MalauD/TIPE2022/Code/Notebooks/data/README.md

## Utilisation des donnés
### Formattage des noms de fichier
Exemple :
`002_chaussure_revetement.csv`

En premier on retrouve le numéro de session et ensuite c'est la chaussure et enfin le revetement
