MalauD/TIPE2022/Diapo/slides/00_titre_et_tdm.tex

\begin{frame}
    \titlepage
\end{frame}

\begin{frame}
    \frametitle{Problématique}
    Quelle est l'influence du type de revêtement de sol et du chaussage sur le corps humain lors de la course à pied ?
\end{frame}

\begin{frame}
    \frametitle{Plan de l'exposé}
    \tableofcontents
\end{frame}
