MalauD/TIPE2022/Diapo/slides/01_intro.tex

\section{Présentation du problème}
\begin{frame}
    \frametitle{Présentation du problème}
    Les sols dans nos villes sont souvent bétonnés et ne sembleraient donc pas optimaux pour les coureurs, est-ce vraiment le cas ? Quelle influence peut avoir le chaussage sur le confort du coureur ?
    \\
    \\
    Nous allons le vérifier à l'aide d'un dispositif expérimental.
\end{frame}
