MalauD/TIPE2022/Diapo/slides/04_conclusion.tex

\section{Conclusion}
\begin{frame}
    \frametitle{Conclusion}
    D'après les résulats expérimentaux et le modèle physique:
    \begin{itemize}
        \item Un chaussage adapté est primordial pour atténuer les chocs
        \item Le revêtement le moins traumatisant est le gazon
    \end{itemize}
    Dès lors, la bétonisation des sols est traumatisante pour les coureurs.
\end{frame}
