MalauD/TIPE2022/Diapo/slides/05_annexe.tex

\section{Annexes}
\subsection{Photos}
\begin{frame}
    \frametitle{Annexe 1}
    \begin{figure}
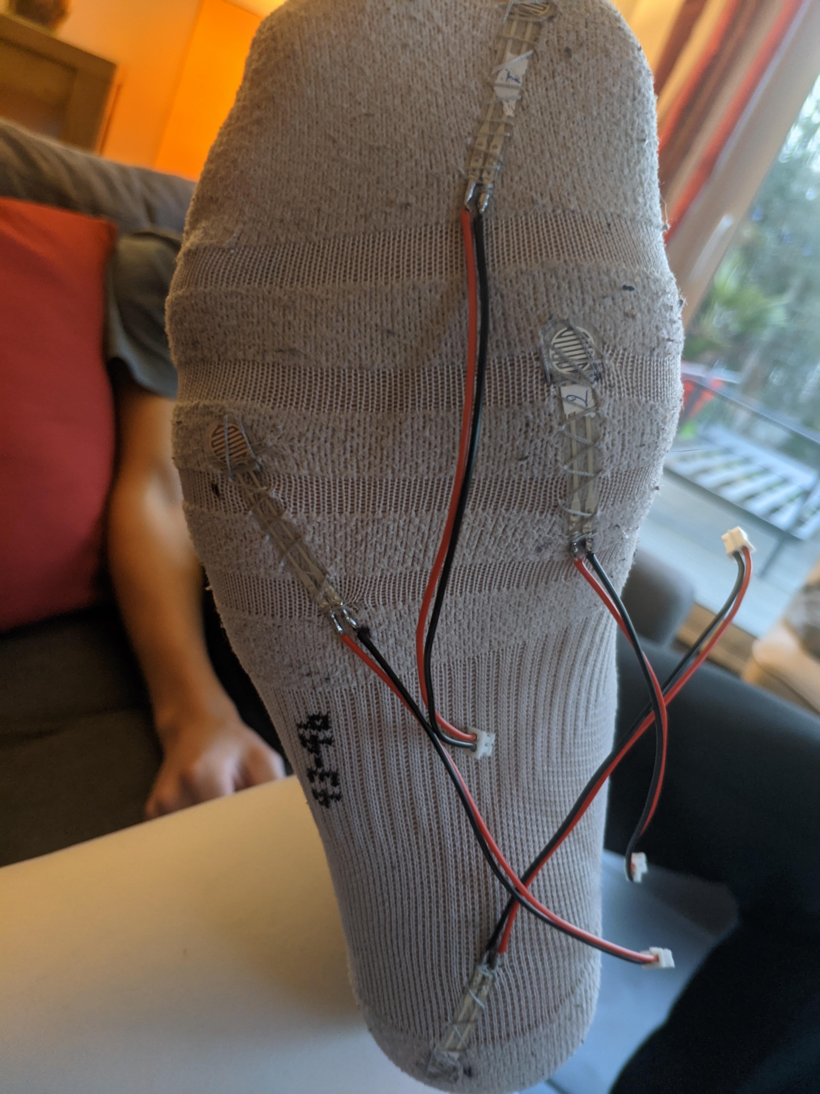
[picture p12: Diapo/figures/chau_02.jpg]
        
    \end{figure}
\end{frame}
\begin{frame}
    \frametitle{Annexe 2}
    \begin{figure}
        
    \end{figure}
\end{frame}
\begin{frame}
    \frametitle{Annexe 3}
    \begin{figure}
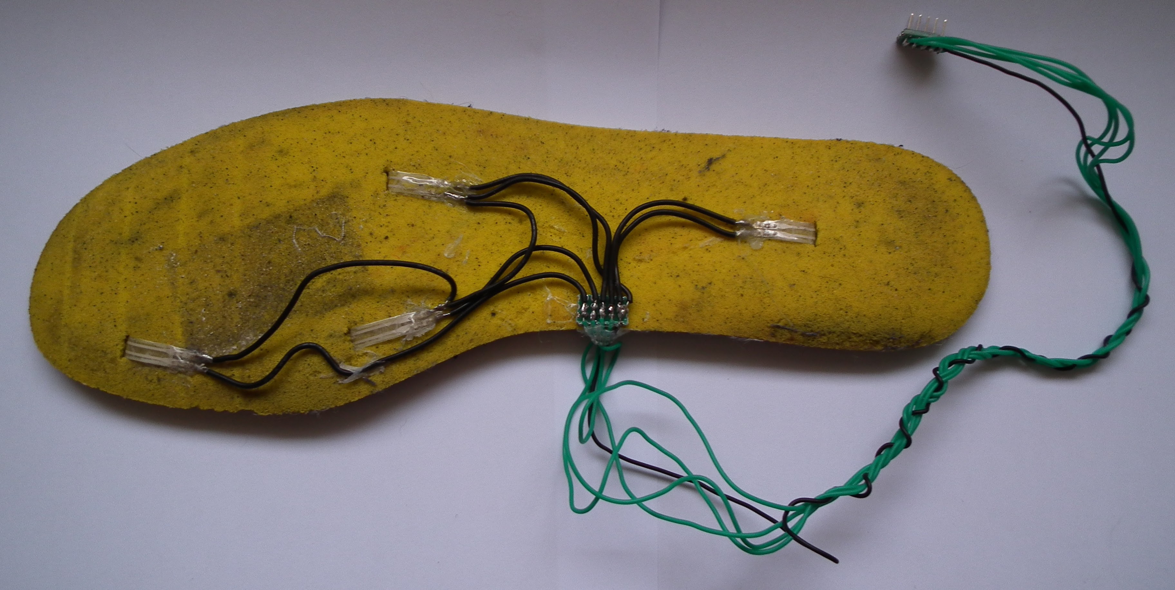
[picture p13: Diapo/figures/sem_03.JPG]
        
    \end{figure}
\end{frame}
\begin{frame}
    \frametitle{Annexe 4}
    \begin{figure}
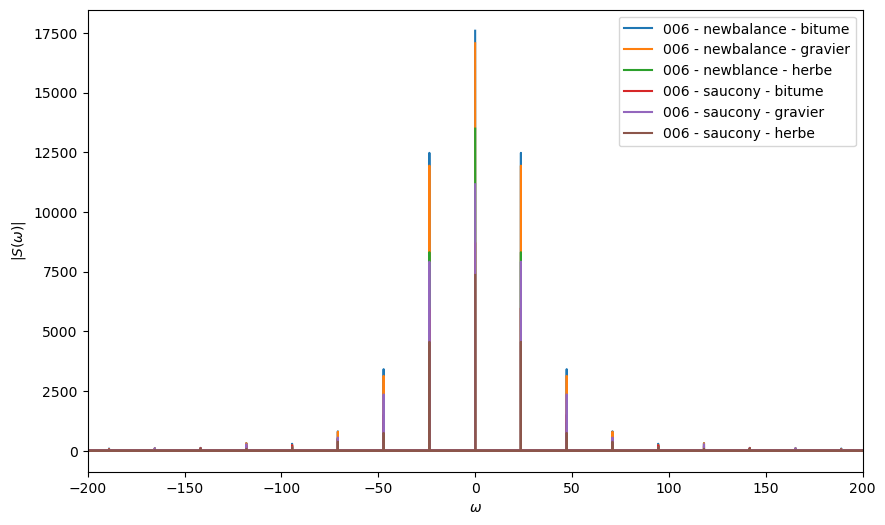
[picture p14: Diapo/figures/rheo_03.png]
        
    \end{figure}
\end{frame}
\begin{frame}
    \frametitle{Annexe 5}
    \begin{figure}
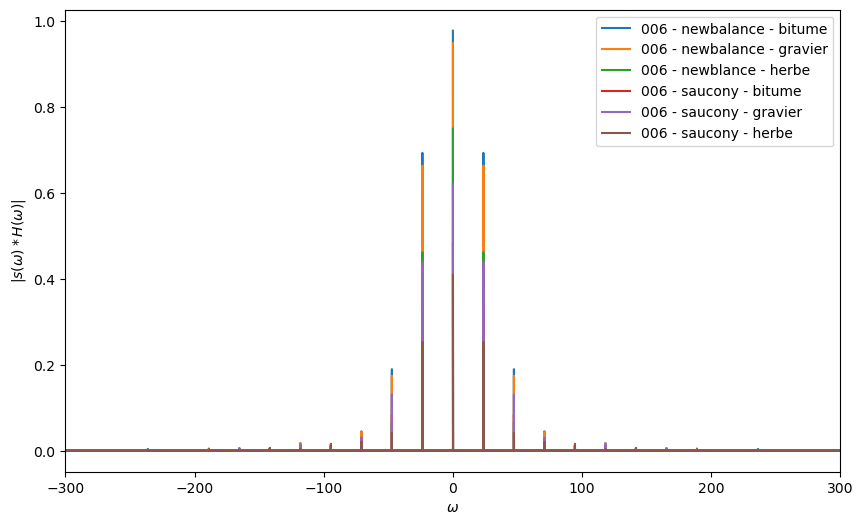
[picture p15: Diapo/figures/rheo_04.png]
        
    \end{figure}
\end{frame}
\subsection{Codes}
\begin{frame}
    \frametitle{Annexe 6}
    \lstinputlisting[language=C++, basicstyle=\tiny, linerange={140-147,160-177}]{../Code/Tipe/include/math/fitting/gradient_desc.hpp}
\end{frame}
\begin{frame}
    \frametitle{Annexe 7}
    \lstinputlisting[language=C++, basicstyle=\tiny, linerange={179-208}]{../Code/Tipe/include/math/fitting/gradient_desc.hpp}
\end{frame}
\begin{frame}
    \frametitle{Annexe 8}
    \lstinputlisting[language=C++, basicstyle=\tiny, linerange={209-226}]{../Code/Tipe/include/math/fitting/gradient_desc.hpp}
\end{frame}
