MalauD/TIPE2022/Diapo/preambule/special_beamer.tex

%%%%%%%%%%%%%%%%%%%%%%%%%%%%%%%%%%%%%%%%%
% Beamer Presentation
% LaTeX Template
% Version 1.0 (10/11/12)
%
% This template has been downloaded from:
% http://www.LaTeXTemplates.com
%
% License:
% CC BY-NC-SA 3.0 (http://creativecommons.org/licenses/by-nc-sa/3.0/)
%
%%%%%%%%%%%%%%%%%%%%%%%%%%%%%%%%%%%%%%%%%

%----------------------------------------------------------------------------------------
%	PACKAGES AND THEMES
%----------------------------------------------------------------------------------------

\mode<presentation> {

  % The Beamer class comes with a number of default slide themes
  % which change the colors and layouts of slides. Below this is a list
  % of all the themes, uncomment each in turn to see what they look like.

  %\usetheme{default}
  %\usetheme{AnnArbor}
  %\usetheme{Antibes}
  %\usetheme{Bergen}
  %\usetheme{Berkeley}
  %\usetheme{Berlin}
  %\usetheme{Boadilla}
  %\usetheme{CambridgeUS}
  %\usetheme{Copenhagen}
  %\usetheme{Darmstadt}
  %\usetheme{Dresden}
  %\usetheme{Frankfurt}
  %\usetheme{Goettingen}
  %\usetheme{Hannover}
  %\usetheme{Ilmenau}
  %\usetheme{JuanLesPins}
  %\usetheme{Luebeck}
  %\usetheme{Madrid}		
  %\usetheme{Malmoe}
  %\usetheme{Marburg}
  %\usetheme{Montpellier}
  %\usetheme{PaloAlto}
  %\usetheme{Pittsburgh}
  %\usetheme{Rochester}
  %\usetheme{Singapore}
  %\usetheme{Szeged}
  \usetheme{Warsaw}

  % As well as themes, the Beamer class has a number of color themes
  % for any slide theme. Uncomment each of these in turn to see how it
  % changes the colors of your current slide theme.

  %\usecolortheme{albatross}
  %\usecolortheme{beaver}
  %\usecolortheme{beetle}
  %\usecolortheme{crane}
  %\usecolortheme{dolphin}
  %\usecolortheme{dove}
  %\usecolortheme{fly}
  %\usecolortheme{lily}
  %\usecolortheme{orchid}
  %\usecolortheme{rose}
  %\usecolortheme{seagull}
  %\usecolortheme{seahorse}
  \usecolortheme{whale}
  %\usecolortheme{wolverine}

  %\setbeamertemplate{footline} % To remove the footer line in all slides uncomment this line
  %\setbeamertemplate{footline}[frame number] % To replace the footer line in all slides with a simple slide count uncomment this line

  %\setbeamertemplate{navigation symbols}{} % To remove the navigation symbols from the bottom of all slides uncomment this line

  \setbeamercovered{transparent} % Fait apparaître les animations en grisé (utile pour la conception, mais peut être commenté lors de la remise du document final)

  % Pour utiliser une police à empattements partout
  \usefonttheme{serif}

  % Pour rajouter la numérotation des frames dans les pieds de page
  % \newcommand*\oldmacro{}%
  % \let\oldmacro\insertshorttitle%
  % \renewcommand*\insertshorttitle{%
  %   \oldmacro\hfill%
  %   \insertframenumber\,/\,\inserttotalframenumber}

}

\usepackage{graphicx} % Allows including images
\usepackage{booktabs} % Allows the use of \toprule, \midrule and \bottomrule in tables
