MalauD/TIPE2022/points.org

Problématique
Objectifs
Modèles (propositions experimentaux etc..)
Des résultats
Bibliographie des idées.
