MalauD/TIPE2022/Diapo/fichier_principal.tex

\RequirePackage{currfile}
\documentclass{beamer}
\input{preambule/special_beamer.tex}
\input{preambule/autres_packages.tex}
\input{preambule/macros.tex}
\usetheme{Madrid}

\title[TIPE Course à pied]{TIPE : l'impact physique de la course à pied}
\author{Malaury \textsc{DUTOUR}}

\institute[TIPE]{Épreuve de TIPE}
\date{Session 2023}

\begin{document}

\input{slides/00_titre_et_tdm.tex}
\input{slides/01_intro.tex}
\input{slides/02_releves.tex}
\input{slides/03_analyse.tex}
\input{slides/04_conclusion.tex}
\input{slides/05_annexe.tex}
\end{document}
