MalauD/TIPE2022/Diapo/annexe_code.pdf

# Annexe TIPE

Malaury DUTOUR - candidat 22977

2022-2023

## Table des mati`eres

1 Extraits du code embarqu´e | 1
2 Extraction des donn´ees de la carte SD | 11

## 1 Extraits du code embarqu´e

### 1.1 Algorithme de descente de gradient

#i fnd e f MATH FITTING GRADIENT DESC HPP #def ine MATH FITTING GRADIENT DESC HPP

#include ” . . / d a t a s e t . hpp”

#include ” f i t t i n g . hpp”

#include <f u n c ti o n al >

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

enum GradientDescCompletion { GRADIENT DESC CONVERGED,
GRADIENT DESC MAX ITERATIONS, } ;

s t d : : s t r i n g g r adien tDe scC omple ti onT oS t rin g ( GradientDescCompletion c om pl e ti o n ) ;

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

s t d : : s t r i n g g r adien tDe scC omple ti onT oS t rin g ( GradientDescCompletion c om pl e ti o n ) {

switch ( c om pl e ti o n ) {
case GRADIENT DESC CONVERGED: return ” Converged ” ;
case GRADIENT DESC MAX ITERATIONS: return ”Max I t e r a t i o n s ” ;
de fau lt :
return ”Unknown” ;
}
}

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

template <typename T, s t d : : s i z e t params count>
void G r adien tDe scRe sul t<T, params count >:: s e r i a l i z e ( s t d : : ostream &o s ) { for ( s t d : : s i z e t i = 0 ; i < params count ; i++) {
o s << params [ i ] << ” , ” ;
}
o s << d a t a se t me an << ” , ” << d a t a s e t s t d ;
}

template <typename T, s t d : : s i z e t params count>
T G radien tDescFac to ry<T, params count >:: c o s t f u n c ( DataSet<T> &data , s t d : : a r ray<T, params count> params ) { T c o s t = data . accumulate ( [ & ] ( DataPoint<T> dp ) {
return s t d : : pow ( func ( dp . x , params ) − dp . y , 2 ) ;
} ) ;
return c o s t / ( 2 ∗ data . s i z e ( ) ) ;
}

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

}
return r e s u l t ;
}

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

d e r i v e p s [ i ] = T ( ) ; }
return grad ;
}

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

T norm grad = 0 ;
for ( s t d : : s i z e t i = 0 ; i < params count ; i++) { norm grad += s t d : : pow ( grad [ i ] , 2 ) ;
}

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

T rmse = s t d : : s q r t ( c o s t / data . s i z e ( ) ) ;
T s s e = c o s t ;
T r 2 = 1 − ( s s e / ( data . s i z e ( ) ∗ s t d : : pow ( data . s t d ( ) , 2 ) ) ) ;

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

return s t d : : make unique<G r adien tDe scRe sul t<T, params count>>(
func , params , data nonnorm . mean ( ) , data nonnorm . s t d ( ) ) ;
} ;

template <typename T, s t d : : s i z e t params count>
s t d : : u ni q u e p t r<Fi t ti n g R e s ul t <T>>
G radien tDescFac to ry<T, params count >:: d e s e r i a l i z e ( s t d : : s t r i n g s t r ) { auto v al u e s = s p l i t ( s t r , ’ , ’ ) ;
s t d : : a r ray<T, params count> params ;
for ( s t d : : s i z e t i = 0 ; i < params count ; i++) {
params [ i ] = s t d : : s t o d ( v al u e s [ i ] ) ;
}
T mean = s t d : : s t o d ( v al u e s [ params count ] ) ;
T s t d = s t d : : s t o d ( v al u e s [ params count + 1 ] ) ;
return s t d : : make unique<G r adien tDe scRe sul t<T, params count>>(func , params , mean , s t d ) ;
} ;

template <typename T, s t d : : s i z e t params count>
s t d : : u ni q u e p t r<Fi t ti n g R e s ul t <T>>
G radien tDescFac to ry<T, params count >:: g e t D e f a ul t ( ) {
s t d : : a r ray<T, params count> params ;
s t d : : f i l l ( params . b e gi n ( ) , params . end ( ) , T ( ) ) ;
return s t d : : make unique<G r adien tDe scRe sul t<T, params count>>(func , params , 0 , 1 ) ;
}

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

#end i f

### 1.2 Manipulation des donn´ees

#i fnd e f MATH DATA SET HPP

#def ine MATH DATA SET HPP

#include <v e c t o r>

template <typename T>
c l a s s DataPoint {
public :
DataPoint (T x , T y ) : x ( x ) , y ( y ) {} T x ;
T y ;
} ;

template <typename T>
c l a s s DataSet {
s t d : : v e c t o r<DataPoint<T>> data ;

public :
DataSet ( ) = de fau lt ;
s t d : : s i z e t s i z e ( ) ;
void appendDataPoint ( DataPoint<T> d a t aP oin t ) ; void ex tend ( DataSet<T> d a t aSe t ) ;
void c l e a r ( ) ;
DataPoint<T> a t ( s t d : : s i z e t inde x ) ;
T accumulate ( s t d : : f u n c ti o n <T( DataPoint<T> &)> func ) ;
DataSet<T> map( s t d : : f u n c ti o n <DataPoint<T>(DataPoint<T> &)> func ) ; DataSet<T> n o rm ali z e ( ) ;
T s t d ( ) ;
T mean ( ) ;
void p r i n t ( ) ;
} ;

template <typename T>
s t d : : s i z e t DataSet<T>:: s i z e ( ) { return data . s i z e ( ) ;
}

template <typename T>
T DataSet<T>:: accumulate ( s t d : : f u n c ti o n <T( DataPoint<T> &)> func ) { T r e s u l t = 0 ;
for ( auto d a t aP oin t : data ) {
r e s u l t += func ( d a t aP oin t ) ; }
return r e s u l t ;
}

template <typename T>
DataSet<T> DataSet<T>::map( s t d : : f u n c ti o n <DataPoint<T>(DataPoint<T> &)> func ) { DataSet<T> r e s u l t ;
for ( auto d a t aP oin t : data ) {
r e s u l t . appendDataPoint ( func ( d a t aP oin t ) ) ; }
return r e s u l t ;
}

template <typename T>
DataSet<T> DataSet<T>:: n o rm ali z e ( ) { DataSet<T> r e s u l t ;
T mean = th is−>mean ( ) ;
T s t d = th is−>s t d ( ) ;
for ( auto d a t aP oin t : data ) { r e s u l t . appendDataPoint (
DataPoint<T>( d a t aP oin t . x , ( d a t aP oin t . y − mean ) / s t d ) ) ; }
return r e s u l t ;
}

template <typename T>
T DataSet<T>:: s t d ( ) {
T mean = th is−>mean ( ) ;
T sum = accumulate ([&mean ] ( DataPoint<T> d a t aP oin t ) { return s t d : : pow ( d a t aP oin t . y − mean , 2 ) ;
} ) ;
return s t d : : s q r t ( sum / s i z e ( ) ) ;
}

template <typename T>
T DataSet<T>::mean ( ) {

return accumulate ( [ ] ( DataPoint<T> d a t aP oin t ) { return d a t aP oin t . y ; }) / s i z e ( ) ;
}

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

template <typename T>
void DataSet<T>:: appendDataPoint ( DataPoint<T> d a t aP oin t ) { data . push back ( d a t aP oin t ) ;
}

template <typename T>
void DataSet<T>:: ex tend ( DataSet<T> d a t aSe t ) {
data . i n s e r t ( data . end ( ) , d a t aSe t . data . b e gi n ( ) , d a t aSe t . data . end ( ) ) ; }

template <typename T>
void DataSet<T>:: c l e a r ( ) { data . c l e a r ( ) ;
}

template <typename T>
DataPoint<T> DataSet<T>:: a t ( s t d : : s i z e t inde x ) { return data [ inde x ] ;
}

#end i f

### 1.3 Sauvergarde et r´estitution des r´esultats de l’ajustemnt de courbe

#i fnd e f CONFIG CONFIG HPP

#def ine CONFIG CONFIG HPP

#include ” . . / i o / adc mux . hpp”

#include ” . . / math/ f i t t i n g / f i t t i n g . hpp” #include ” Li t tl e F S . h”

#include <a r ray>

#include <iomanip>

#include <ostream>

#include <sstream>

#include <s t ri n g >

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

void p r i n t ( ) ;
void s e tT oD e f a ul t ( ) ;

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

template <typename T, s t d : : s i z e t s i z e >

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

#end i f

### 1.4 Exemple de configuration stockant les r´esultats de l’ajustement de courbe

4
0. 7 0 7 4 9 5 4 , 1. 1 1 6 5 3 , −1. 7 4 4 1 8 6 , 2 5 0 0. 0 9 1 , 1 5 8 0. 9 9 5
0. 8 6 2 5 0 6 2 , 1. 2 8 4 7 9 , −1. 4 8 6 1 1 5 , 2 2 7 7. 8 8 9 , 1 6 0 0. 3 8 2
0. 3 3 7 4 4 7 5 , 2. 0 8 2 8 6 8 , −1. 3 8 3 8 1 9 , 2 5 0 0. 1 4 3 , 1 7 9 2. 6 4 4
1. 4 8 6 8 4 3 , 1. 0 9 5 0 4 4 , −1. 9 5 5 2 7 3 , 2 3 5 0. 1 , 1 5 8 1. 7 8 1
11
3. 3 0 0 7 5 0 , 1. 0 0 0 0 0 0
1. 6 0 6 6 2 5 , 5 0 0. 0 0 0 0 0 0
0. 8 9 9 3 7 5 , 1 0 0 0. 0 0 0 0 0 0
0. 6 2 7 6 2 5 , 1 5 0 0. 0 0 0 0 0 0
0. 5 2 4 5 0 0 , 2 0 0 0. 0 0 0 0 0 0
0. 3 9 3 6 2 5 , 2 5 0 0. 0 0 0 0 0 0
0. 3 1 9 1 2 5 , 3 0 0 0. 0 0 0 0 0 0
0. 3 3 0 0 0 0 , 3 5 0 0. 0 0 0 0 0 0
0. 3 1 5 6 2 5 , 4 0 0 0. 0 0 0 0 0 0
0. 3 5 2 0 0 0 , 4 5 0 0. 0 0 0 0 0 0
0. 2 4 9 5 0 0 , 5 0 0 0. 0 0 0 0 0 0 9
3. 3 0 0 7 5 0 , 1. 0 0 0 0 0 0
2. 1 2 0 5 0 0 , 5 0 0. 0 0 0 0 0 0
1. 3 1 9 8 7 5 , 1 0 0 0. 0 0 0 0 0 0
0. 9 5 7 6 2 5 , 1 5 0 0. 0 0 0 0 0 0
0. 7 1 3 0 0 0 , 2 0 0 0. 0 0 0 0 0 0
0. 5 3 2 2 5 0 , 3 0 0 0. 0 0 0 0 0 0
0. 4 3 6 3 7 5 , 3 5 0 0. 0 0 0 0 0 0
0. 4 2 4 3 7 5 , 4 0 0 0. 0 0 0 0 0 0
0. 3 8 1 2 5 0 , 5 0 0 0. 0 0 0 0 0 0 7
3. 3 0 6 0 0 0 , 1. 0 0 0 0 0 0
1. 2 6 5 0 0 0 , 5 0 0. 0 0 0 0 0 0
0. 6 5 6 0 0 0 , 1 5 0 0. 0 0 0 0 0 0
0. 4 8 4 2 5 0 , 2 5 0 0. 0 0 0 0 0 0
0. 4 4 0 5 0 0 , 3 5 0 0. 0 0 0 0 0 0
0. 3 8 8 0 0 0 , 4 5 0 0. 0 0 0 0 0 0
0. 3 6 0 5 0 0 , 5 0 0 0. 0 0 0 0 0 0 10
3. 3 0 6 8 7 5 , 1. 0 0 0 0 0 0
1. 7 3 8 6 2 5 , 5 0 0. 0 0 0 0 0 0
1. 2 1 5 0 0 0 , 1 0 0 0. 0 0 0 0 0 0
0. 9 9 3 0 0 0 , 1 5 0 0. 0 0 0 0 0 0
0. 7 7 6 7 5 0 , 2 0 0 0. 0 0 0 0 0 0
0. 7 3 7 6 2 5 , 2 5 0 0. 0 0 0 0 0 0
0. 6 5 5 2 5 0 , 3 0 0 0. 0 0 0 0 0 0
0. 6 9 9 6 2 5 , 3 5 0 0. 0 0 0 0 0 0
0. 4 6 5 2 5 0 , 4 5 0 0. 0 0 0 0 0 0

0. 4 4 5 0 0 0 , 5 0 0 0. 0 0 0 0 0 0

## 2 Extraction des donn´ees de la carte SD

### 2.1 Code r´ealisant l’extraction

#include ” s t d i o . h”

#include <s t d l i b . h>

#include ” s t d i n t . h”

#include ” s t r i n g . h”

int main ( int argc , char ∗ argv [ ] ) {
FILE ∗ in , ∗ out ;
u i n t 1 6 t time ;
i n t 1 6 t ch1 , ch2 , ch3 , ch4 ;

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

i n = f open ( argv [ 1 ] , ” rb ” ) ;

char ∗outName = m all oc ( s t r l e n ( argv [ 1 ] ) + 5 ) ; s t r c p y ( outName , argv [ 1 ] ) ;
outName [ s t r l e n ( argv [ 1 ] ) − 4 ] = ’ \0 ’ ;
s t r c a t ( outName , ” . c s v ” ) ;
out = f open ( outName , ”w” ) ;

i f ( i n == NULL)
{
p r i n t f ( ”Could not open f i l e %s \n” , argv [ 1 ] ) ; return −1;
}

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

### 2.2 Extrait de la sortie du programme

Time , Channel 1 , Channel 2 , Channel 3 , Channel 4 1 8 6 9 0 , −1 7 6 6 3 , 1 9 9 7 8 , 1 3 8 2 9 , 1 0 7 5 5
1 9 9 7 0 , −1 9 7 1 1 , 1 7 1 6 2 , 2 4 5 8 1 , 2 1 7 6 3
2 0 4 8 2 , −1 4 3 3 5 , 1 7 1 6 2 , 2 9 7 0 1 , 1 9 4 5 9
2 0 2 2 6 , −1 4 8 4 7 , 1 8 9 5 4 , 2 9 1 8 9 , 2 3 2 9 9
1 9 7 1 4 , −2 5 5 9 9 , 1 7 6 7 4 , 2 9 4 4 5 , 3 1 7 4 7 20738 , −18431 ,16906 ,30725 , −32253 19714 , −20991 ,18698 , −32251 , −31997 19714 , −26623 ,16650 , −30971 , −27645 21506 ,32001 ,17674 , −27643 , −22013
