MalauD/TIPE2022/Diapo/MALAURY_DUTOUR_final1.pdf

# TIPE : l’impact physique de la course à pied

## Malaury DUTOUR

## Épreuve de TIPE

## Session 2023

Malaury DUTOUR (TIPE) | TIPE Course à pied | Session 2023 | 1 / 27

# Problématique

## Quelle est l’influence du type de revêtement de sol et du chaussage sur le corps humain lors de la course à pied ?

Malaury DUTOUR (TIPE) | TIPE Course à pied | Session 2023 | 2 / 27

# Plan de l’exposé

1 | Présentation du problème
2 | Relevés expérimentaux Présentation du dispositf expérimental Calibration du dispositif Premiers résultats
3 | Visualisation des résulats expérimentaux et modèle physique Visualisations Modèle physique
4 | Conclusion
5 | Annexes Photos Codes
Malaury DUTOUR (TIPE) | TIPE Course à pied | Session 2023 | 3 / 27

# Présentation du problème

## Les sols dans nos villes sont souvent bétonnés et ne sembleraient donc pas optimaux pour les coureurs, est-ce vraiment le cas ? Quelle influence peut avoir le chaussage sur le confort du coureur ?

Nous allons le vérifier à l’aide d’un dispositif expérimental.

Malaury DUTOUR (TIPE) | TIPE Course à pied | Session 2023 | 4 / 27

# Présentation du dispositif expérimental

## Afin de mesurer les chocs subis par le coureur nous avons réalisé une semelle particulière dotée de : 4 capteurs de pression Un lecteur de carte SD Un microcontrôleur

Malaury DUTOUR (TIPE) | TIPE Course à pied | Session 2023 | 5 / 27

# Carte de contrôle

## Voici la carte avec le microcontrôleur, les convertisseurs

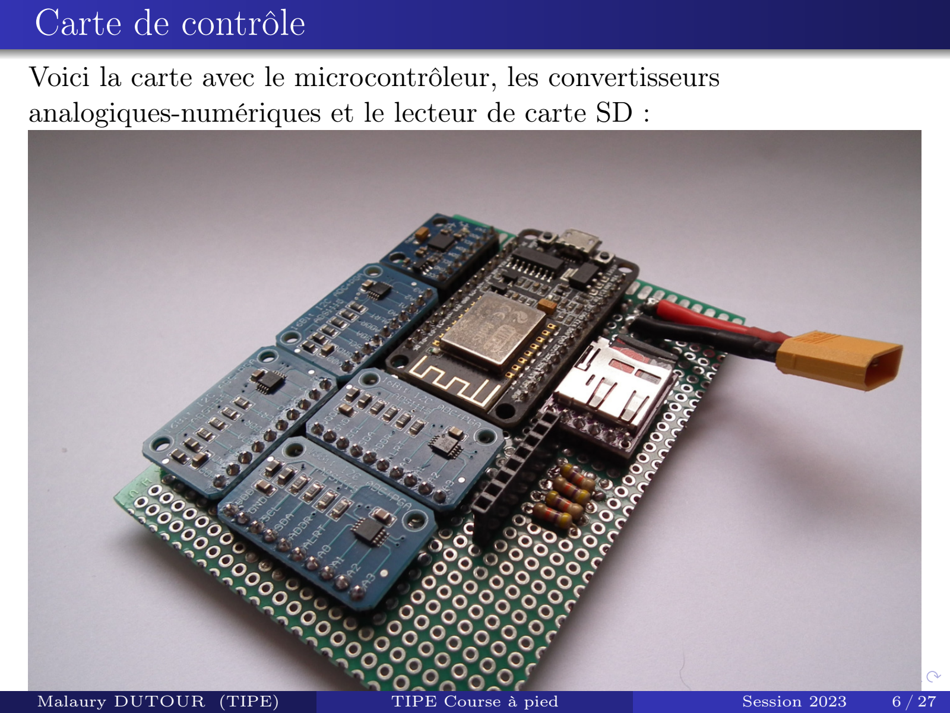
[picture p16: page 6]

## analogiques-numériques et le lecteur de carte SD :

Malaury DUTOUR (TIPE) | TIPE Course à pied | Session 2023 | 6 / 27

# Le capteur de pression DF9-40

Le capteur de pression est une résistance variable de loi non linéaire.

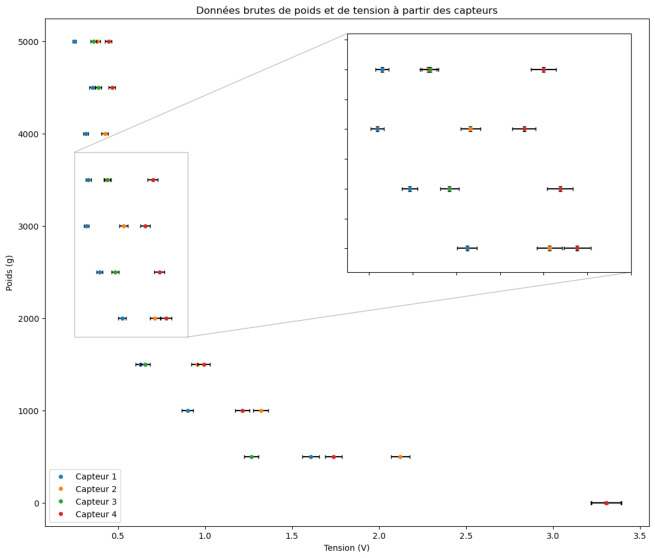
[picture p17: figure]

Malaury DUTOUR (TIPE) | TIPE Course à pied | Session 2023 | 7 / 27

# Calibration - ajustement de courbe 1/2

## Envisageons la fonction suivante : fa,b,c(x) = a

xb + c

## Notons xi

## les valeurs en tension correspondant à un poids mesuré yi

## Il faut trouver a,b,c minimisant Pn

i=0(fa,b,c(xi) − yi)

2

Malaury DUTOUR (TIPE) | TIPE Course à pied | Session 2023 | 8 / 27

# Calibration - ajustement de courbe 2/2

## Nous utilisons la méthode de la descente de gradient pour trouver une valeur approchée de a,b,c minimisant C(a, b, c) = Pn

i=0(fa,b,c(xi) − yi)

2

## L’ideal est d’avoir ∂C

## ∂a (a, b, c) = 0 ∂C

## ∂b (a, b, c) = 0 ∂C

## ∂c (a, b, c) = 0, soit

∇C = 0.

## Pour cela fixons α ∈ R

## +, le taux d’apprentissage et un seuil ε ∈ R

+.

## Nous construisons la suite Pk =

ak
bk
ck

## - de la façon suivante :

## P0 fixé de manière arbitraire

## Pk+1 = Pk − α × ∇C

## Condition d’arrêt : ∇C < ε

Malaury DUTOUR (TIPE) | TIPE Course à pied | Session 2023 | 9 / 27

# Calibration - résultats 1/2

## Résultats de la méthode des moindres carrés avec la descente de gradient effectuée sur la carte :

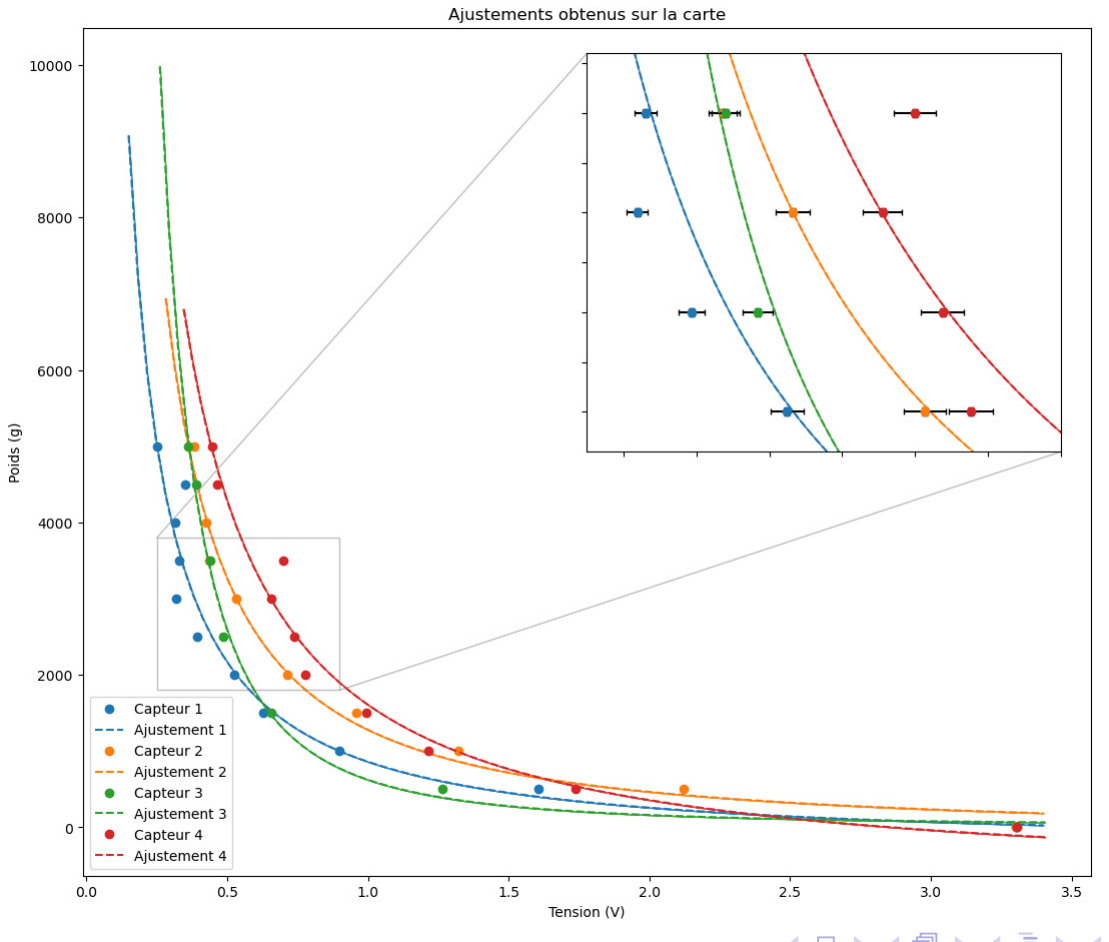
[picture p18: figure]

Malaury DUTOUR (TIPE) | TIPE Course à pied | Session 2023 | 10 / 27

# Calibration - résultats 2/2

## Comparaison avec la fonction curve_fit de scipy :

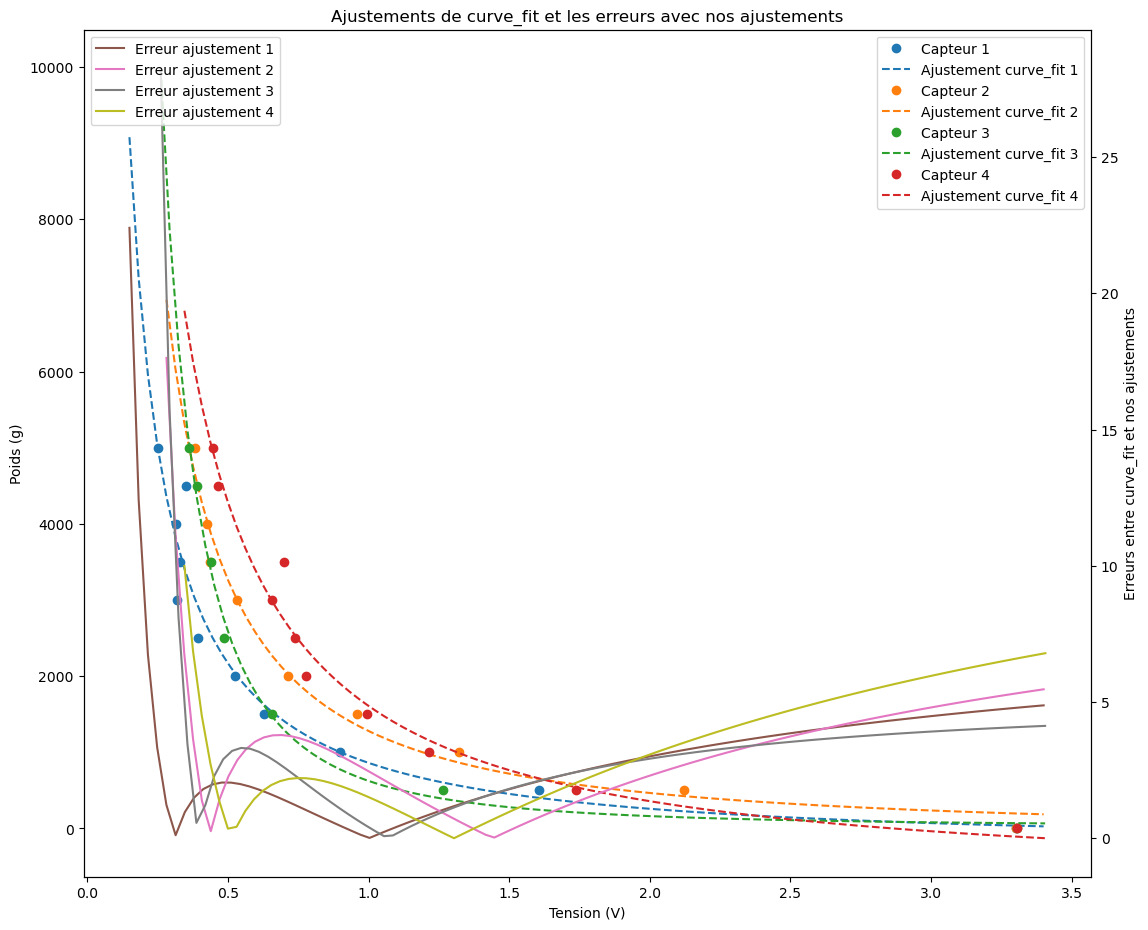
[picture p19: figure]

Malaury DUTOUR (TIPE) | TIPE Course à pied | Session 2023 | 11 / 27

# La semelle

## Voici les capteurs disposés sur la semelle :

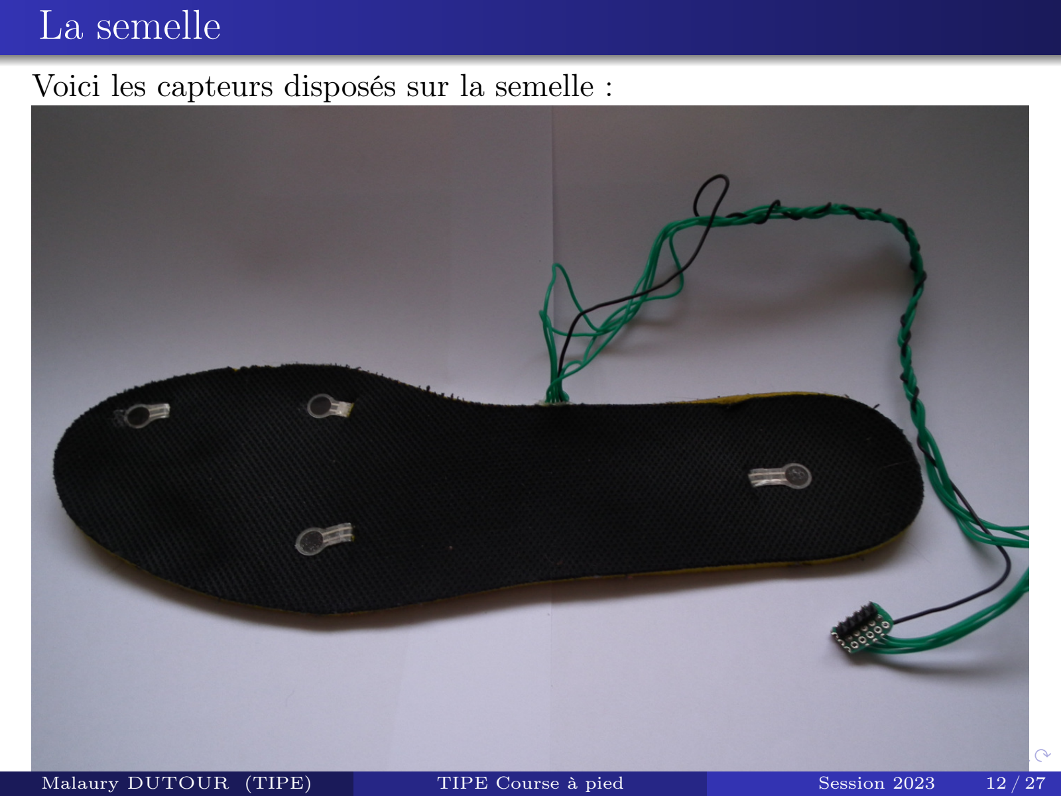
[picture p20: page 12]

Malaury DUTOUR (TIPE) | TIPE Course à pied | Session 2023 | 12 / 27

# Les premiers résultats

## Après avoir couru sur différents revêtements (béton, gravier, pelouse)

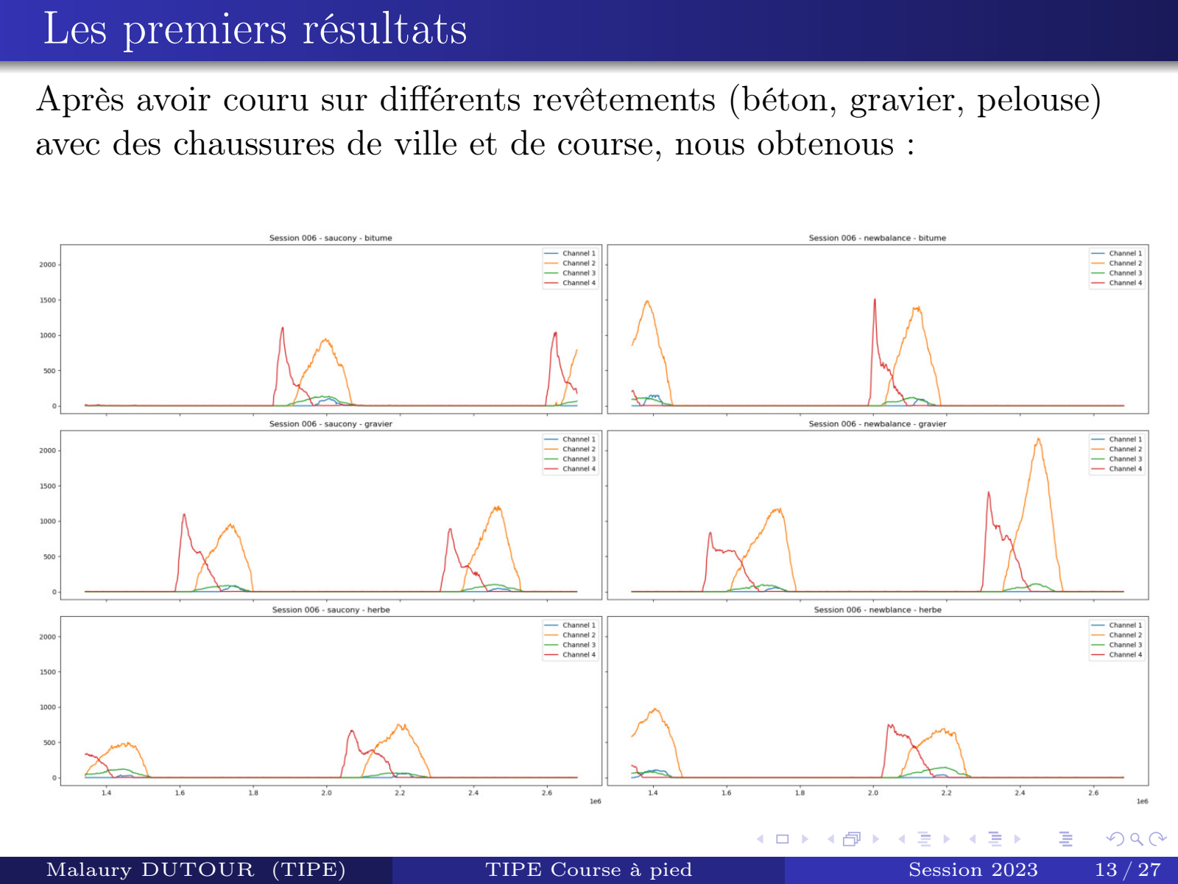
[picture p21: page 13]

## avec des chaussures de ville et de course, nous obtenous :

Malaury DUTOUR (TIPE) | TIPE Course à pied | Session 2023 | 13 / 27

# Quelques visualisations 1/3

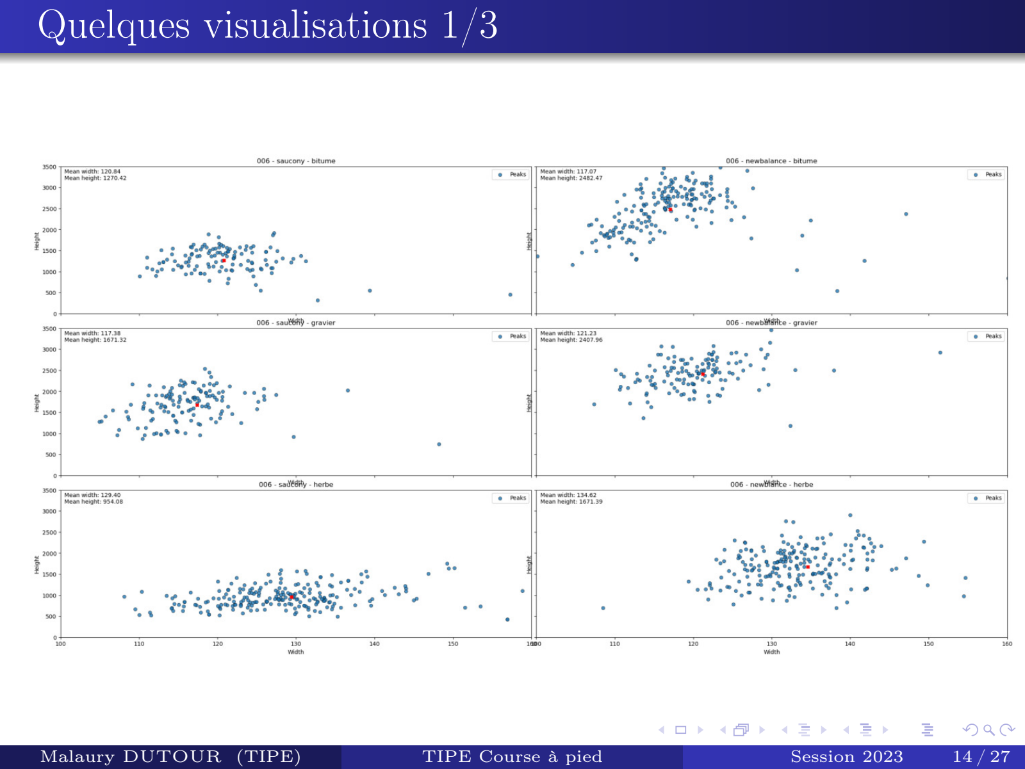
[picture p22: page 14]

Malaury DUTOUR (TIPE) | TIPE Course à pied | Session 2023 | 14 / 27

# Quelques visualisations 2/3

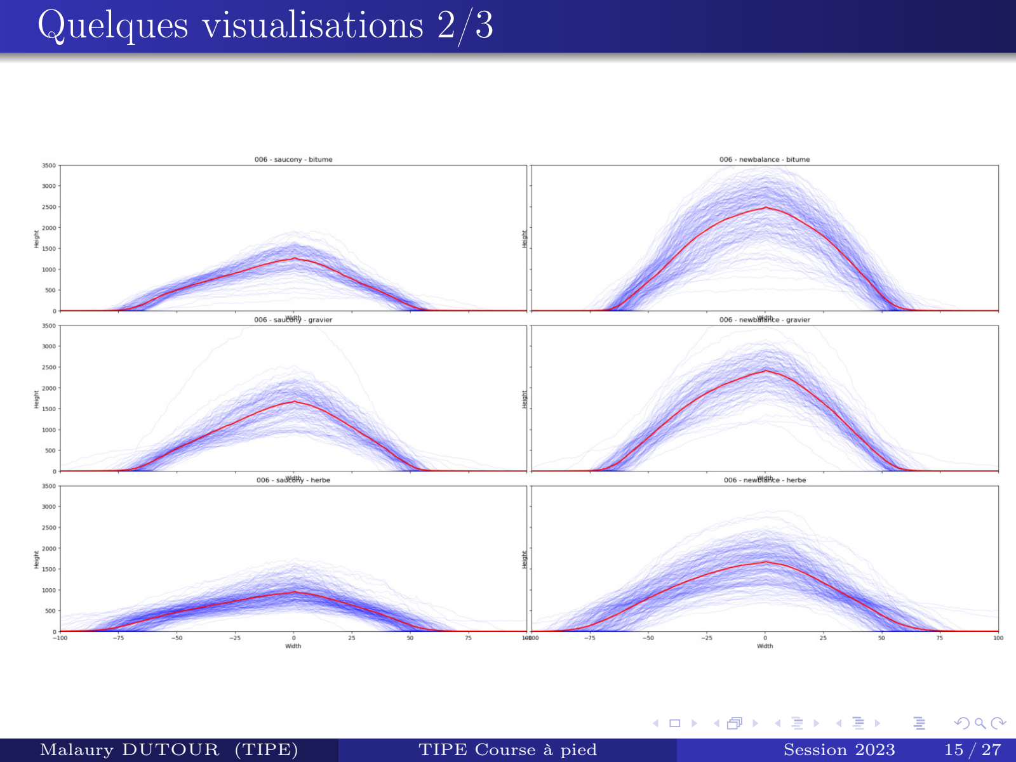
[picture p23: page 15]

Malaury DUTOUR (TIPE) | TIPE Course à pied | Session 2023 | 15 / 27

# Quelques visualisations 3/3

## Gardons ici les pics moyens pour chaque revêtement et type de chaussures :

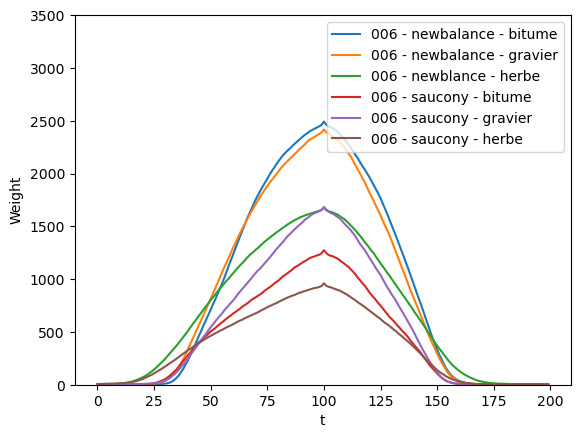
[picture p24: figure]

Malaury DUTOUR (TIPE) | TIPE Course à pied | Session 2023 | 16 / 27

# Rhéologie

## L’os est un matériau viscoélastique, utilisons le modèle de Kelvin-Voigt :

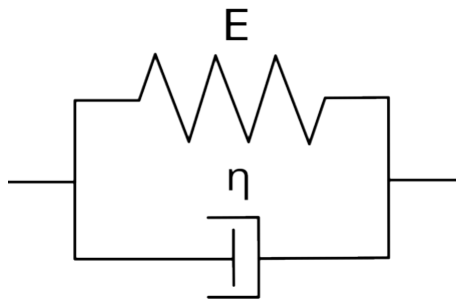
[picture p25: figure]

## Nous établissons l’équation différentielle suivante :

## σ = E × ε + η ×

dε
dt

## Et la fonction de transfert associée :

## H(ω) = 1 E + iωη

## avec E = 18 · 10⁹GP a η = 218, 4P a · sec⁻¹

Malaury DUTOUR (TIPE) | TIPE Course à pied | Session 2023 | 17 / 27

# Résultats

## Puisque ω 10³

## rad · sec⁻¹

## , nous avons H(ω) ≈

1
E

## on obtient donc :

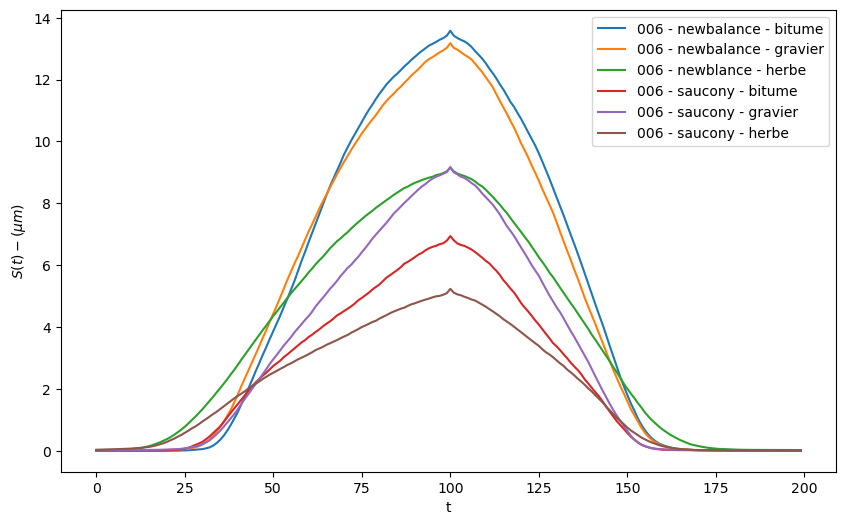
[picture p26: figure]

Malaury DUTOUR (TIPE) | TIPE Course à pied | Session 2023 | 18 / 27

# Conclusion

## D’après les résulats expérimentaux et le modèle physique : Un chaussage adapté est primordial pour atténuer les chocs Le revêtement le moins traumatisant est le gazon

Dès lors, la bétonisation des sols est traumatisante pour les coureurs.

Malaury DUTOUR (TIPE) | TIPE Course à pied | Session 2023 | 19 / 27

# Annexe 1

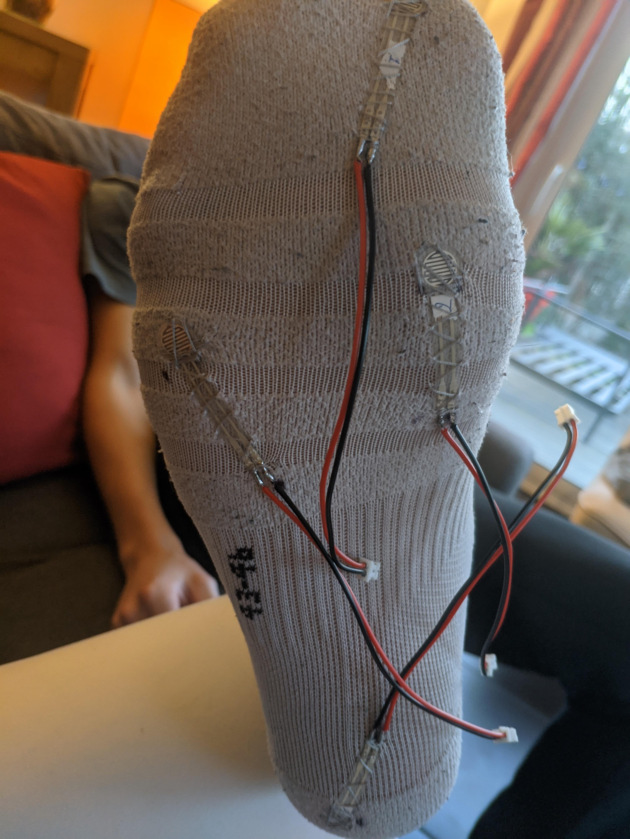
[picture p27: figure]

Malaury DUTOUR (TIPE) | TIPE Course à pied | Session 2023 | 20 / 27

# Annexe 2

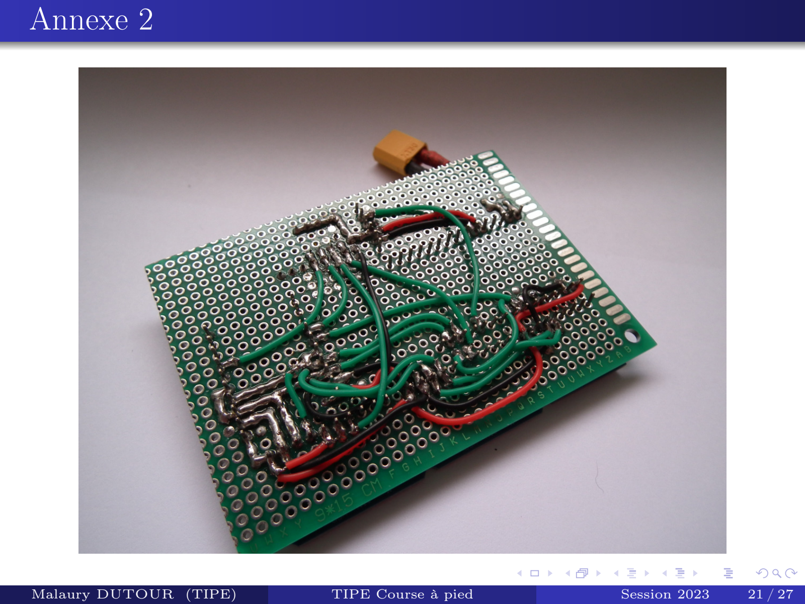
[picture p28: page 21]

Malaury DUTOUR (TIPE) | TIPE Course à pied | Session 2023 | 21 / 27

# Annexe 3

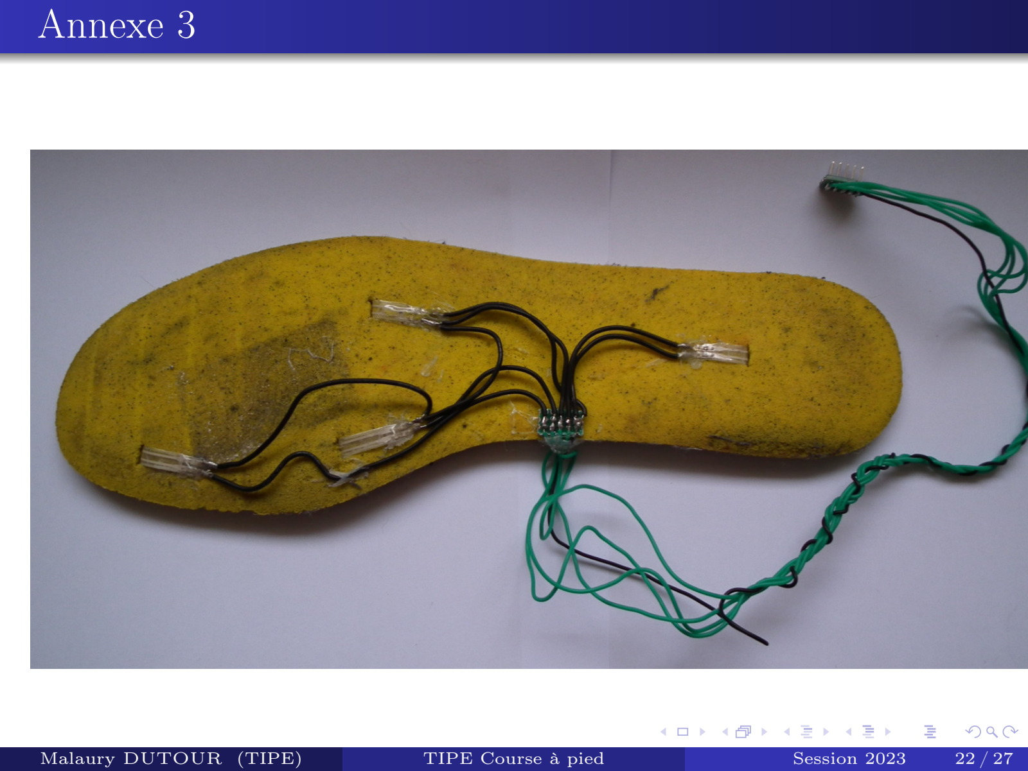
[picture p29: page 22]

Malaury DUTOUR (TIPE) | TIPE Course à pied | Session 2023 | 22 / 27

# Annexe 4

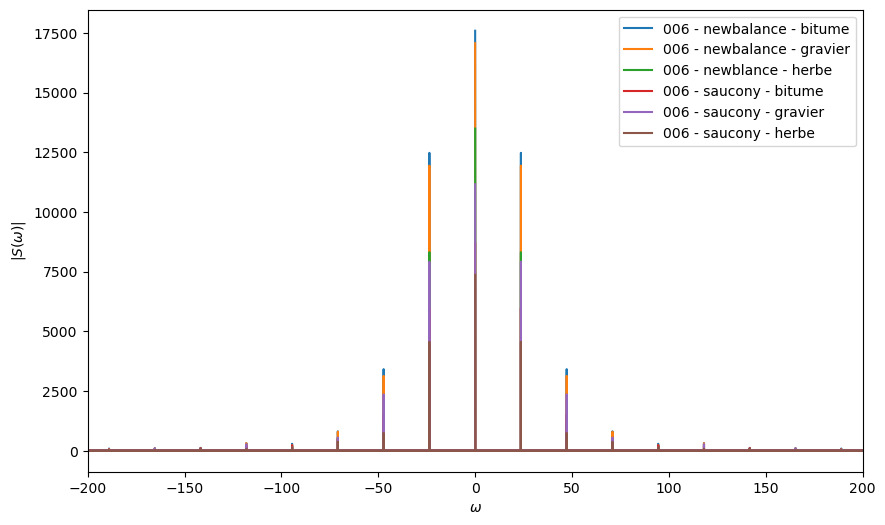
[picture p30: figure]

Malaury DUTOUR (TIPE) | TIPE Course à pied | Session 2023 | 23 / 27

# Annexe 5

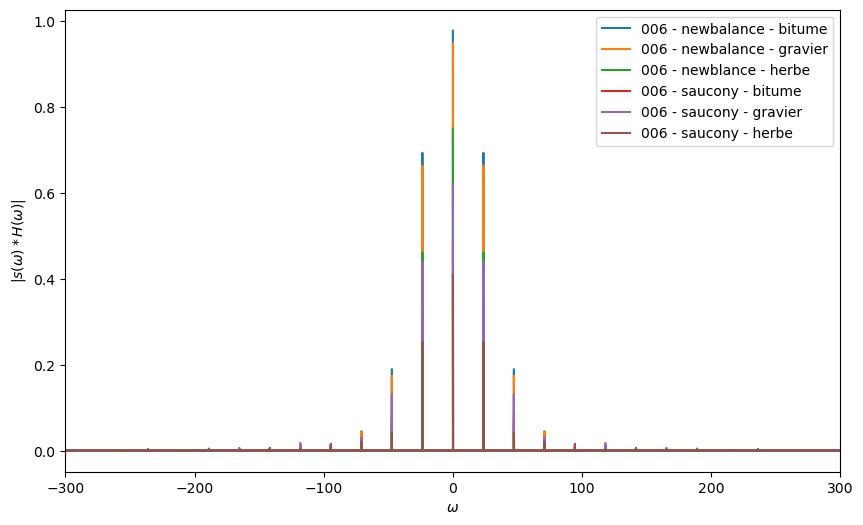
[picture p31: figure]

Malaury DUTOUR (TIPE) | TIPE Course à pied | Session 2023 | 24 / 27

# Annexe 6

template <typename T , s t d : : s i z e_ t params_count>
T Grad i entD es cFa ctory<T , params_count > : : c o s t_ fun c (
DataSet<T> &data , s t d : : array<T , params_count> params ) { T c o s t = data . a c cumu lat e ( [ & ] ( DataPo int<T> dp ) {
return s t d : : pow ( fun c ( dp . x , params ) − dp . y , 2 ) ;
} ) ;
return c o s t / ( 2 ∗ data . s i z e ( ) ) ;
}
template <typename T , s t d : : s i z e_ t params_count>
s t d : : array<T , params_count>
Grad i entD es cFa ctory<T , params_count > : : grad_cost_ func ( DataSet<T> &data , s t d : : array<T , params_count> params ) { s t d : : array<T , params_count> grad ;
s t d : : array<T , params_count> d e r iv_ ep s ;
s t d : : f i l l ( d e r iv_ ep s . b e g in ( ) , d e r iv_ ep s . end ( ) , T ( ) ) ;
T h = s t d : : pow ( s t d : : num e r i c_ l im i t s<T> : : e p s i l o n ( ) , T( 1 . 0 / 3 . 0 ) ) ; fo r ( s t d : : s i z e_ t i = 0 ; i < params_count ; i++) {
d e r iv_ ep s [ i ] = h ;
grad [ i ] = ( c o s t_ fun c ( data , add_arr ( params , d e r iv_ ep s ) ) −
c o s t_ fun c ( data , add_arr ( params , d er iv_ eps , T( −1 . 0 ) ) ) ) / ( 2 ∗ h ) ;

d e r iv_ ep s [ i ] = T ( ) ;
}
return grad ;
}
Malaury DUTOUR (TIPE) | TIPE Course à pied | Session 2023 | 25 / 27

# Annexe 7

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

T norm_grad = 0 ;
fo r ( s t d : : s i z e_ t i = 0 ; i < params_count ; i++) { norm_grad += s t d : : pow ( grad [ i ] , 2 ) ;
}

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

# Annexe 8

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

T rmse = s t d : : s q r t ( c o s t / data . s i z e ( ) ) ;
T s s e = c o s t ;
T r 2 = 1 − | ( s s e / ( data . s i z e ( ) ∗ | s t d : : pow ( data . s t d ( ) , 2 ) ) ) ;

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

return s t d : : make_unique<G r ad i en tD e s cR e su l t<T , params_count>>(
func , params , data_nonnorm . mean ( ) , data_nonnorm . s t d ( ) ) ;
} ;
Malaury DUTOUR (TIPE) | TIPE Course à pied | Session 2023 | 27 / 27
