MalauD/TIPE2022/Diapo/fichier_principal.pdf

## TIPE: l’impact physique de la course à pied

Malaury DUTOUR

Épreuve de TIPE

Session 2023

Malaury DUTOUR | TIPE Course à pied | 1 / 4 | 1 / 4

## Problématique

Mettre en évidence les traumatismes causés par la course à pied urbaine suivant différents chaussages et type de foulée.

Malaury DUTOUR | TIPE Course à pied | 2 / 4 | 2 / 4

## Plan de l’exposé

Malaury DUTOUR | TIPE Course à pied | 3 / 4 | 3 / 4

## Présentation du problème

Les sols dans nos villes sont souvent bétonnés et ne sembleraient donc pas idéals pour les coureurs, est-ce vraiment le cas ?

Nous allons le vérifier à l’aide d’un dispositif expérimental.

Malaury DUTOUR | TIPE Course à pied | 4 / 4 | 4 / 4
