MalauD/TIPE2022/Diapo/figures/cal_00.png

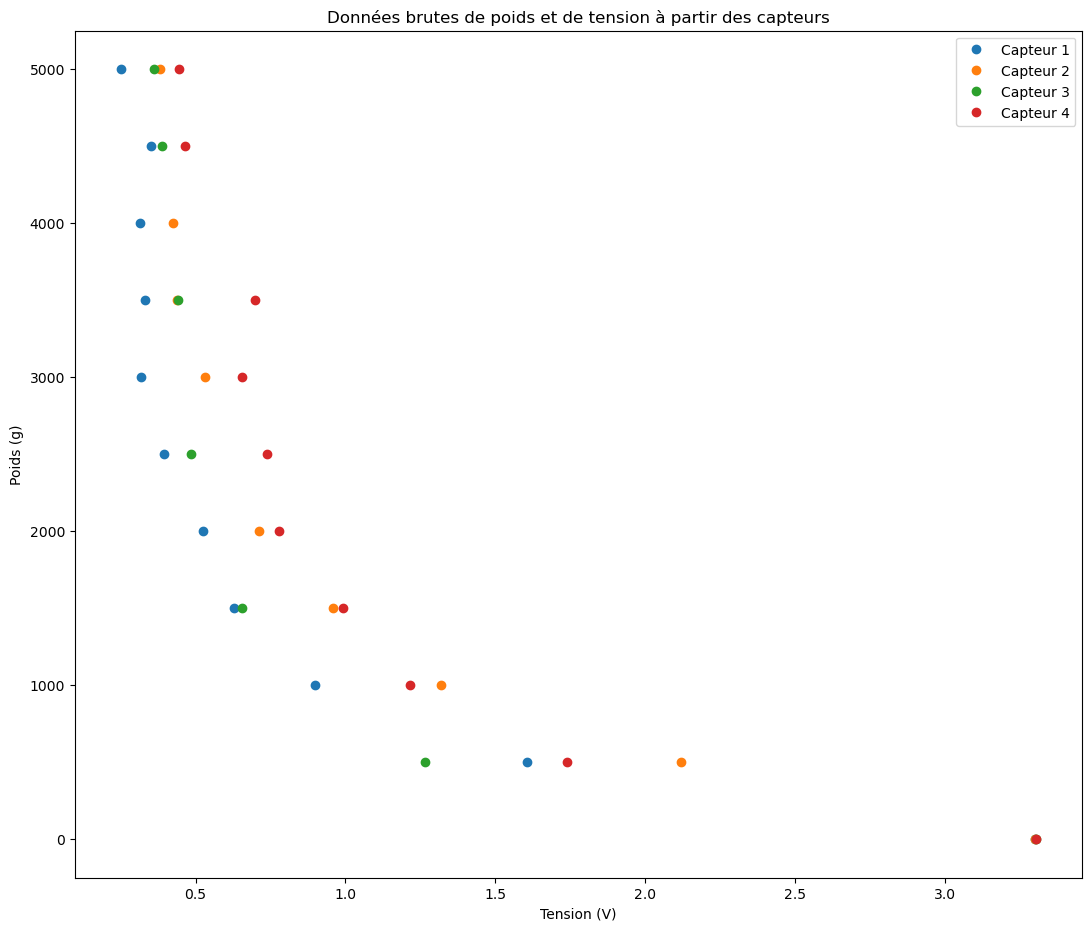
Diapo/figures/cal_00.png
