MalauD/TIPE2022/Diapo/figures/cal_01.png

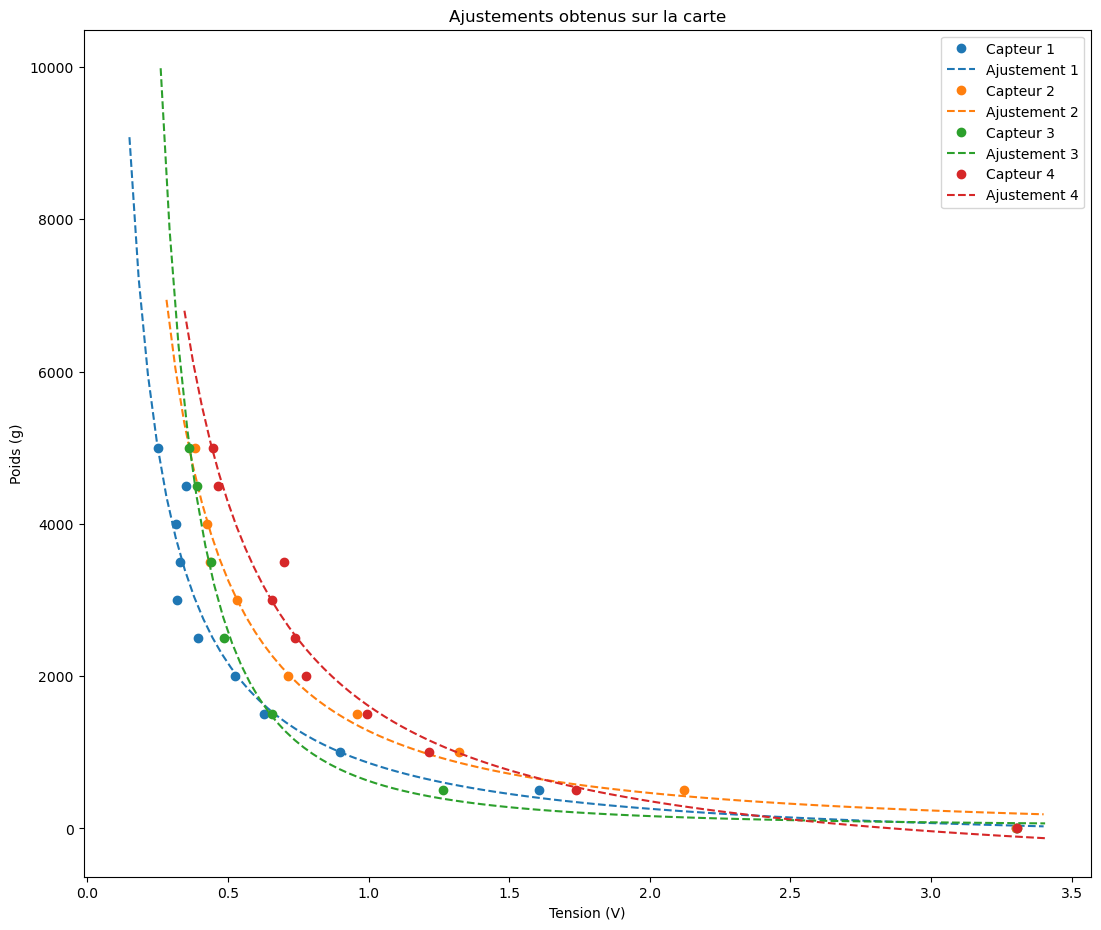
Diapo/figures/cal_01.png
