MalauD/TIPE2022/Diapo/figures/carte_01.JPG

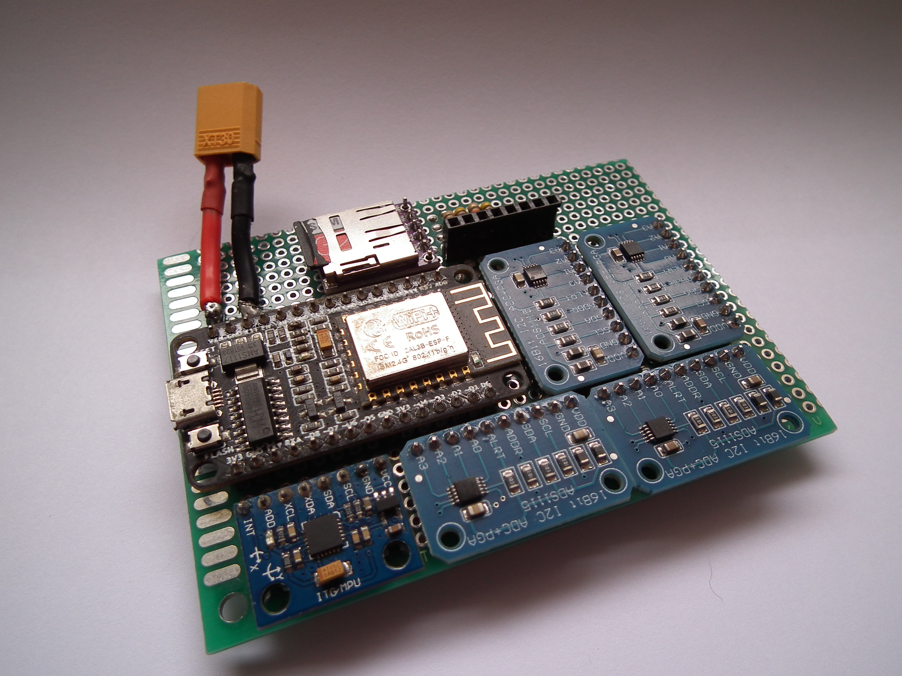
Diapo/figures/carte_01.JPG
