MalauD/TIPE2022/Diapo/figures/carte_04.jpg

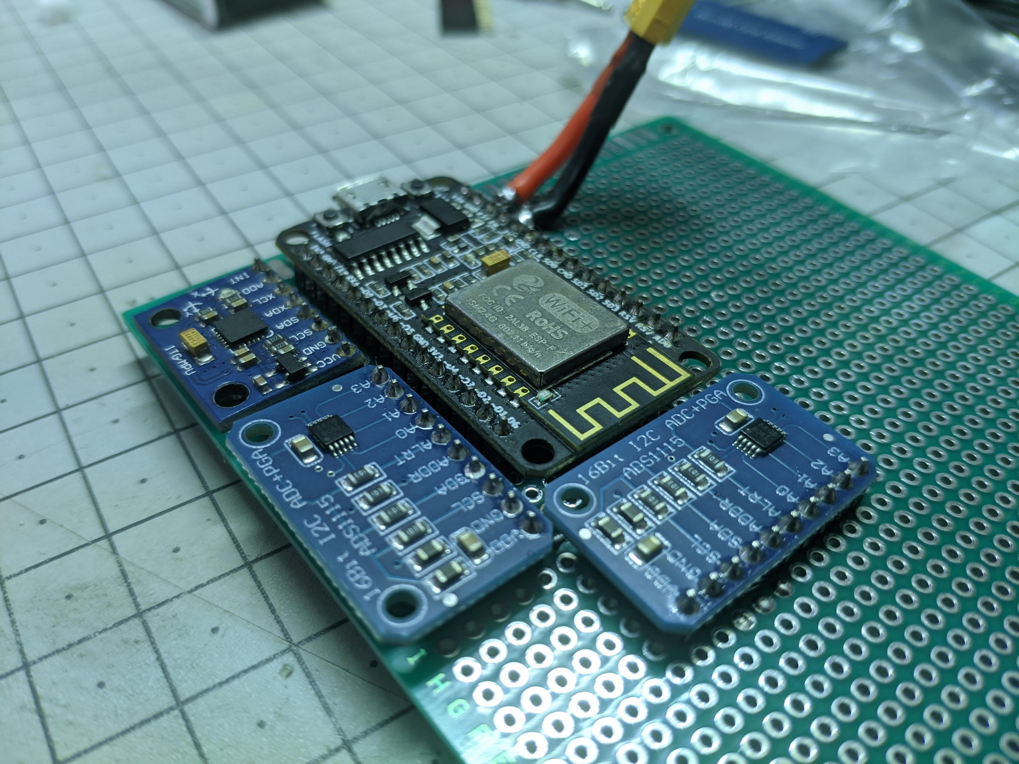
Diapo/figures/carte_04.jpg
