MalauD/TIPE2022/Diapo/figures/carte_05.jpg

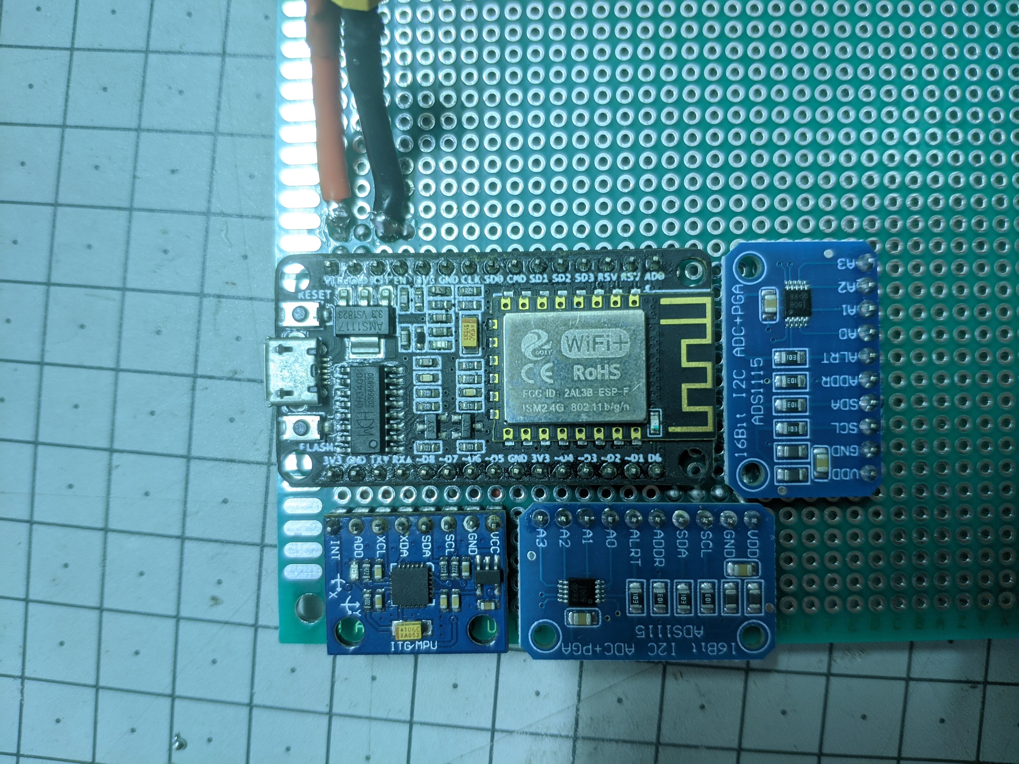
Diapo/figures/carte_05.jpg
