MalauD/TIPE2022/Diapo/figures/carte_06.jpg

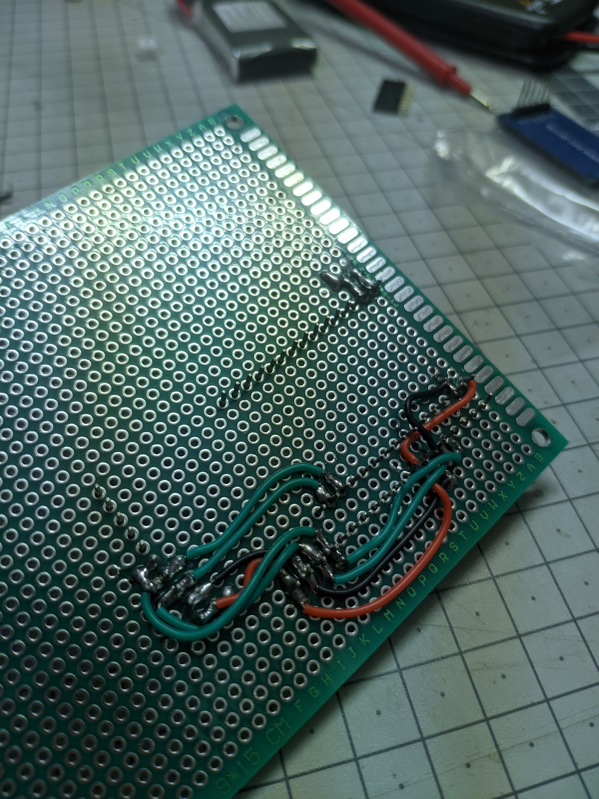
Diapo/figures/carte_06.jpg
