MalauD/TIPE2022/Diapo/figures/chau_00.jpg

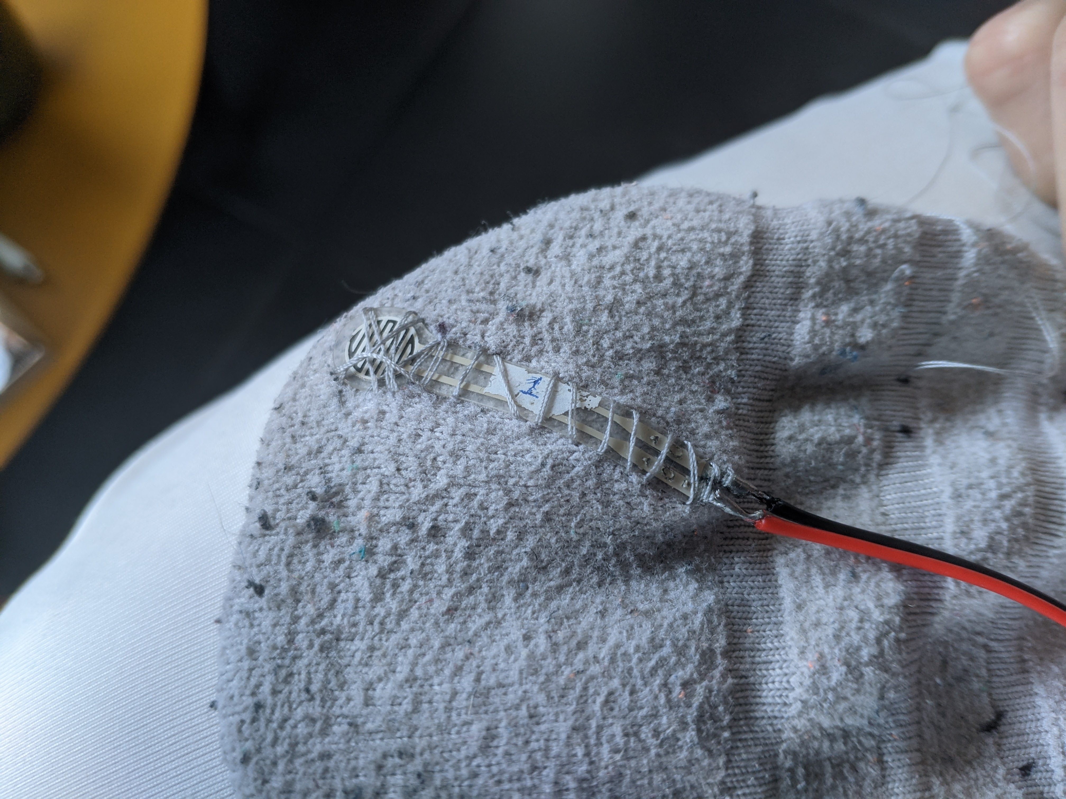
Diapo/figures/chau_00.jpg
