MalauD/TIPE2022/Diapo/figures/chau_01.jpg

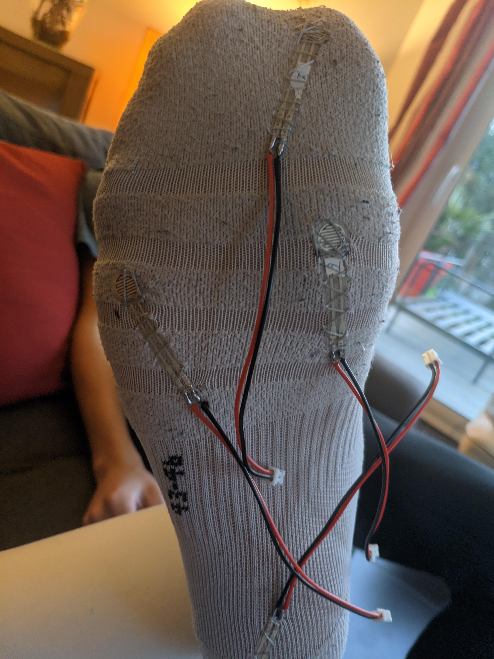
Diapo/figures/chau_01.jpg
