MalauD/TIPE2022/Diapo/figures/chau_03.jpg

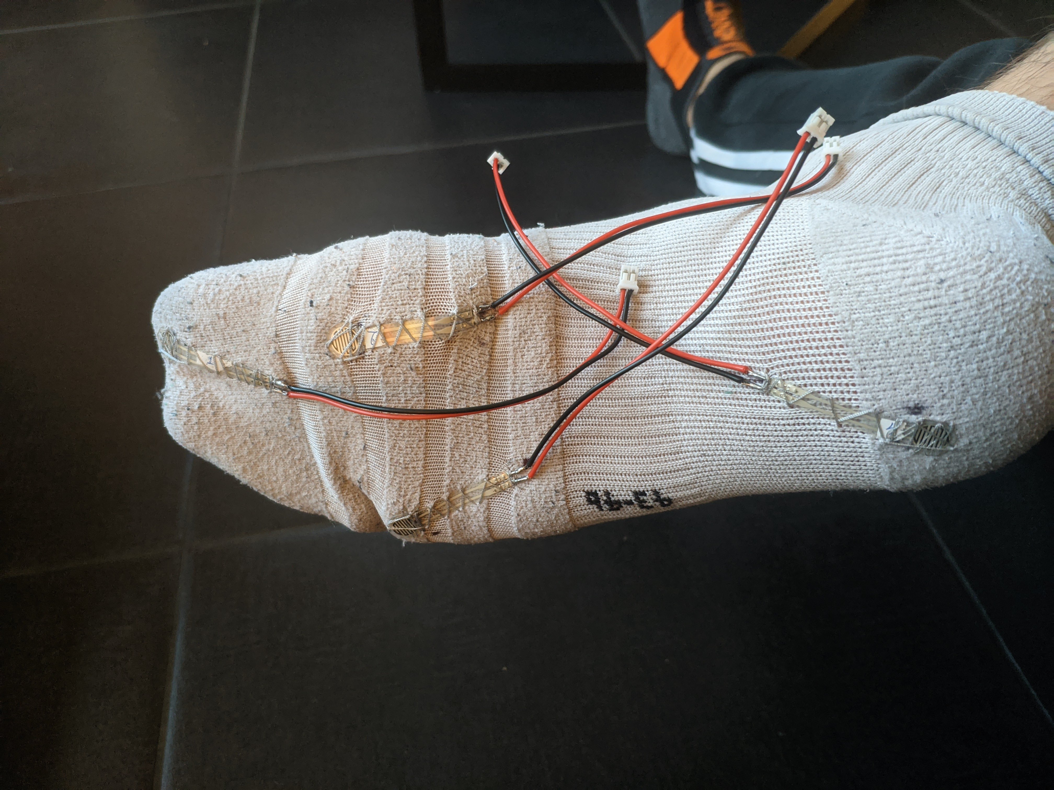
Diapo/figures/chau_03.jpg
