MalauD/TIPE2022/Diapo/figures/res_00.png

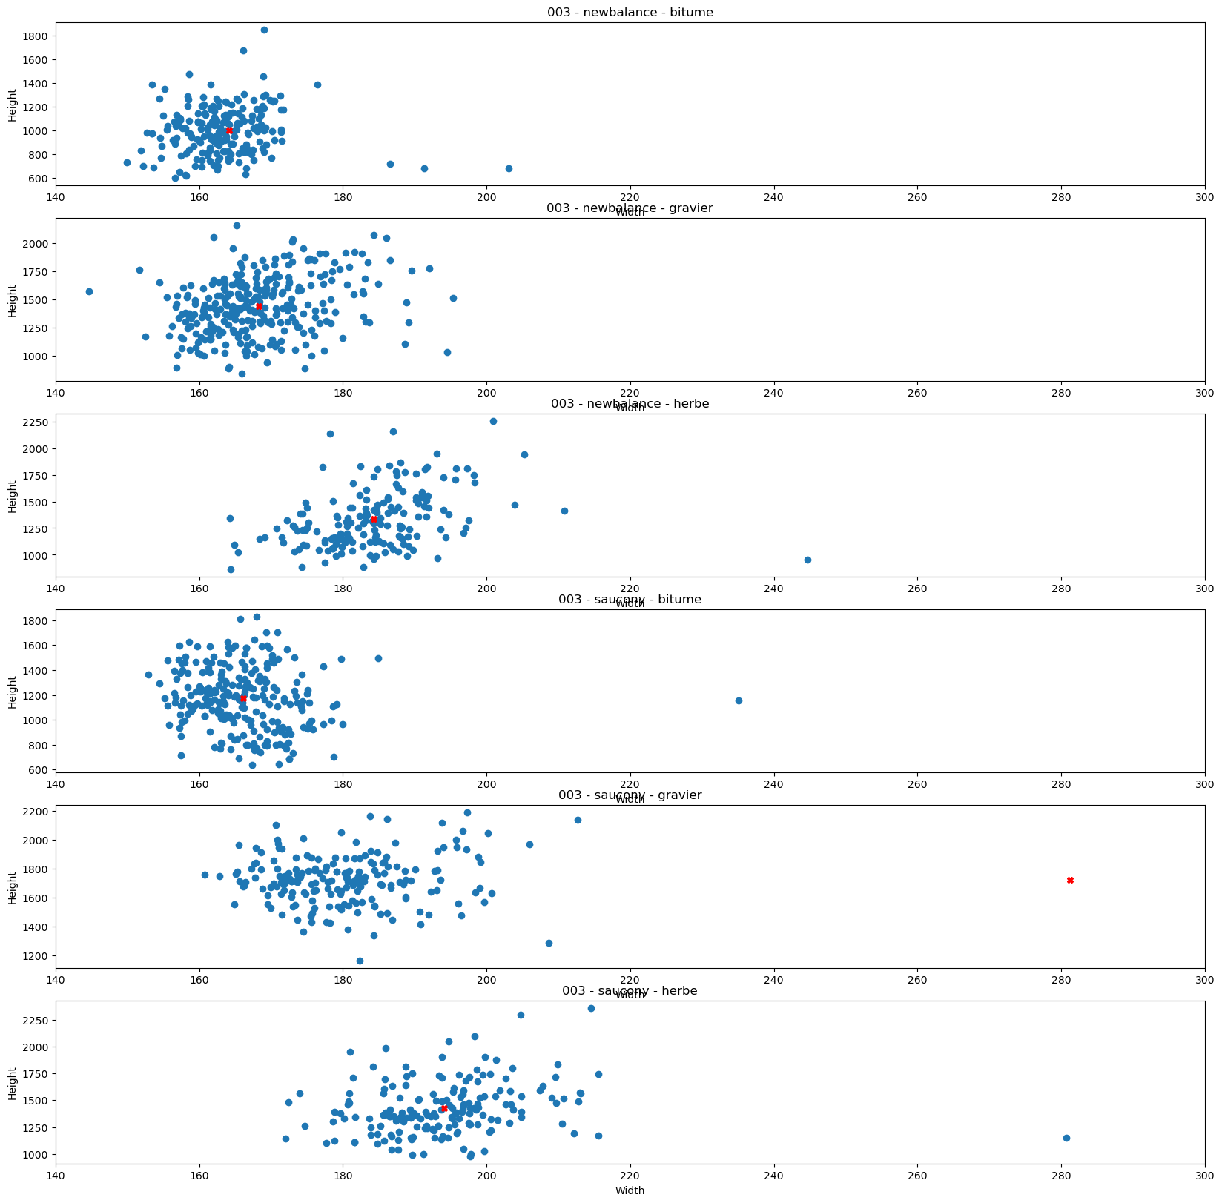
Diapo/figures/res_00.png
