MalauD/TIPE2022/Diapo/figures/rheo_01.png

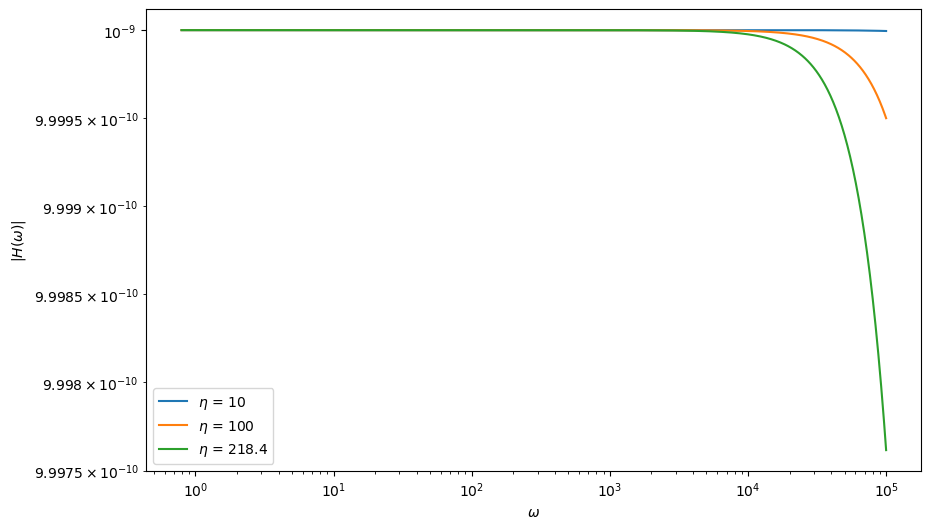
Diapo/figures/rheo_01.png
