MalauD/TIPE2022/Diapo/figures/sem_01.JPG

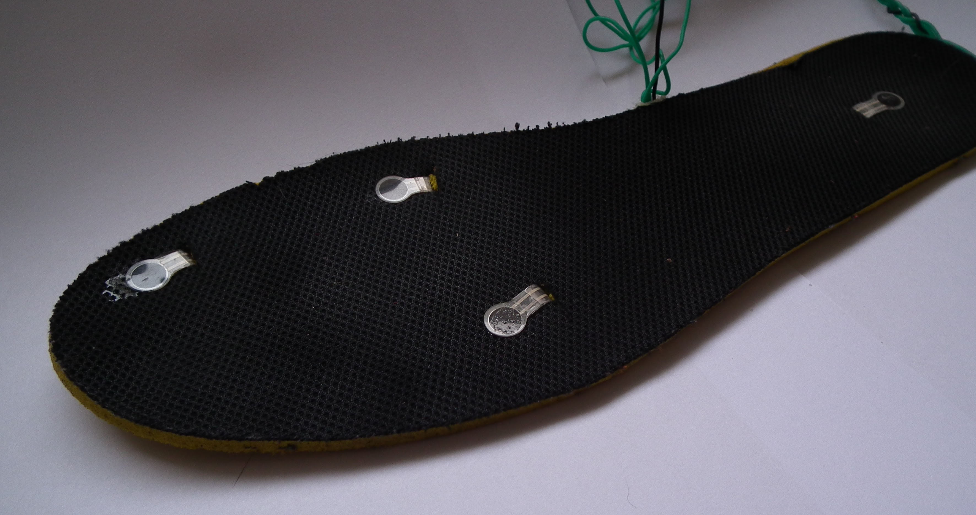
Diapo/figures/sem_01.JPG
