MalauD/TIPE2022/Diapo/figures/sem_02.JPG

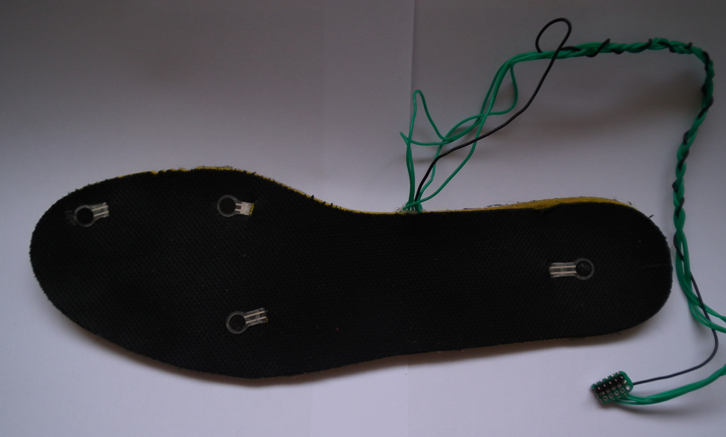
Diapo/figures/sem_02.JPG
