MalauD/TIPE2022/Diapo/figures/sem_04.JPG

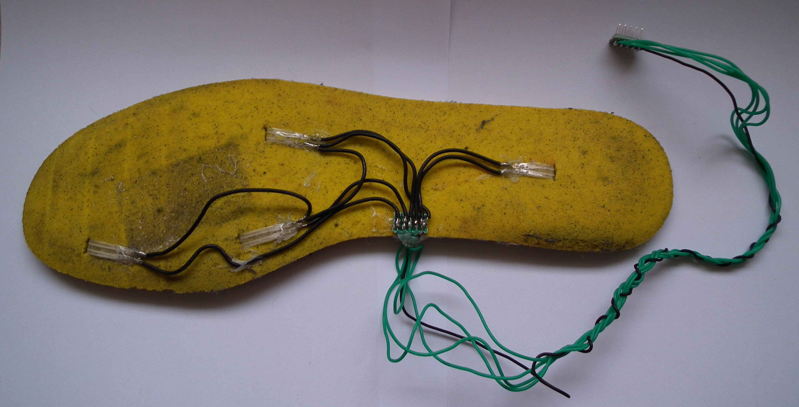
Diapo/figures/sem_04.JPG
