MalauD/TIPE2022/Diapo/figures/sttq_00.png

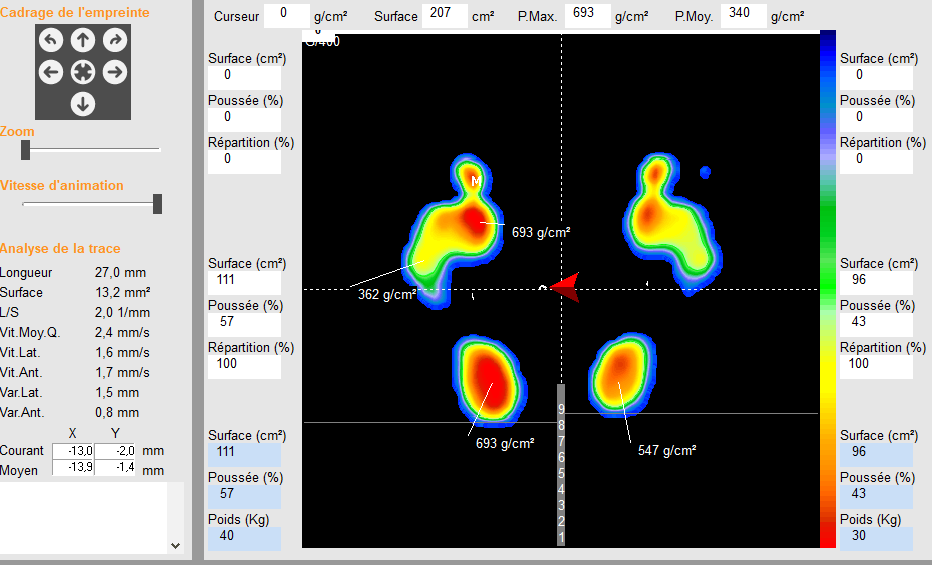
Diapo/figures/sttq_00.png
