MalauD/TIPE2022/Modeles/stls/BancTest_piston_ext.stl

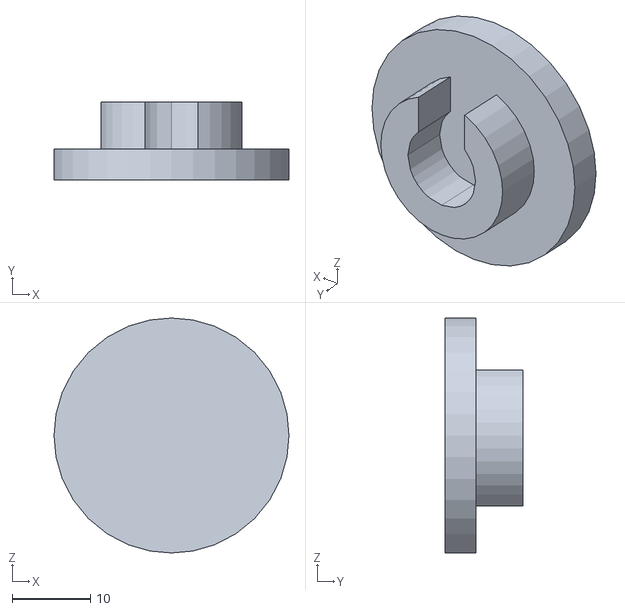
[picture p47: CAD file, 2022-12-04]
Modeles/stls/BancTest_piston_ext.stl
30.0 x 10.0 x 30.0
