MalauD/TIPE2022/Modeles/stls/BancTest_piston_int.stl

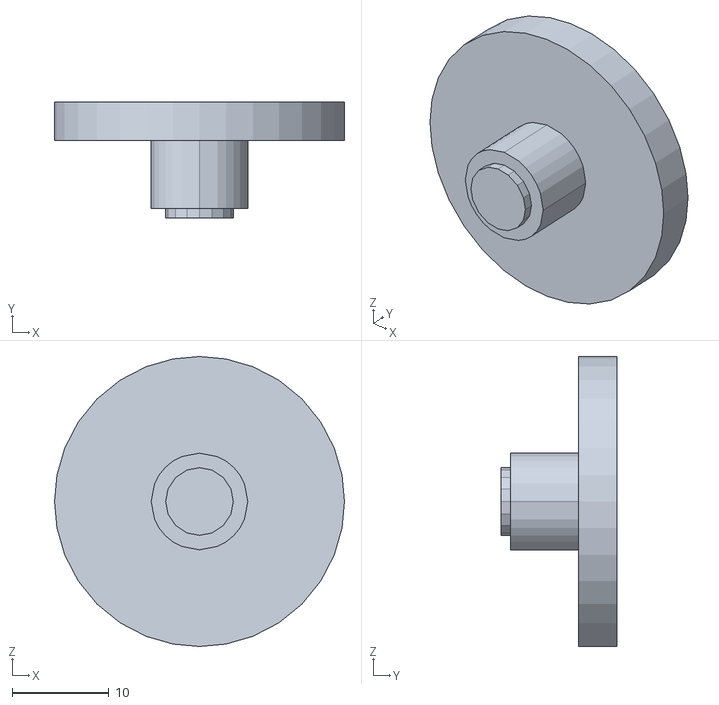
[picture p48: CAD file, 2022-12-04]
Modeles/stls/BancTest_piston_int.stl
30.0 x 12.0 x 30.0
