MalauD/TIPE2022/Code/Tipe/src/main.cpp

#include "manager.hpp"
#include "math/fitting/gradient_desc.hpp"
#include "math/fitting/linear_regression.hpp"
#include <Arduino.h>
#include <ESP8266WiFi.h>

void setup() {
    WiFi.mode(WIFI_OFF);
    WiFi.forceSleepBegin();

    Serial.begin(115200);
    // ESP.wdtDisable();
    //  *((volatile uint32_t *)0x60000900) &= ~(1);
    auto func = [](double x, std::array<double, 3> coef) {
        return coef[0] / std::pow(x, coef[1]) + coef[2];
    };
    GradientDescSettings<double, 3> settings(0.1, 1e-8, 10000, {0.5, 0.5, 0.5});

    auto factory_grad =
        std::make_unique<GradientDescFactory<double, 3>>(func, settings);

    auto factory = std::make_unique<LinearRegressionFactory<double>>();
    Manager<double, 4> manager{std::move(factory_grad)};
    manager.run();
}

void loop() {}
