MalauD/TIPE2022/(commit log)

2022-09-29 ajout de 2 thèses
2022-09-29 ajout de 1 thèse
2022-11-20 ajout des dispositifs de test
    [BancTest_piston_ext.stl, BancTest_piston_int.stl]
2022-11-27 Completed calibration code
2022-11-30 grandissement des pièces du banc de test
    [BancTest_piston_ext.stl, BancTest_piston_int.stl]
2022-12-03 Calibration is now working
2022-12-04 speed up adc reading
2022-12-04 Changed support 3d files
    [BancTest_piston_ext.stl, BancTest_piston_int.stl]
2022-12-11 Sd card logging update
    [configs.txt]
2022-12-18 Fixed some errors
    [configs.txt]
2022-12-19 Not inverting data in dataset
    [data.csv]
2022-12-20 Fixed errors with gradient descent
    [main.cpp]
2022-12-21 ajustement du modele
    [data.csv, data_ok.csv]
2023-01-08 fixed gradient descent
    [config.txt]
2023-01-14 séance labo
    [data.csv]
2023-01-14 Added visualisation of config
    [config.txt]
2023-01-22 update config on board for all 4 sensors
    [config.txt]
2023-02-10 Created a reliable way to save data to sd card in binary (750hz max)
2023-02-26 Ajout de relevés
    [003_newbalance_bitume.csv, 003_newbalance_gravier.csv, 003_newbalance_herbe.csv, 003_saucony_bitume.csv, 003_saucony_gravier.csv, 003_saucony_herbe.csv]
2023-03-02 Changed sensors
    [config.txt]
2023-03-05 Nouvelles experiences
    [003_newbalance_bitume.csv, 003_newbalance_gravier.csv, 003_newbalance_herbe.csv, 003_saucony_bitume.csv, 003_saucony_gravier.csv, 003_saucony_herbe.csv, 005_saucony_bitume.csv, 005_saucony_gravier.csv]
2023-03-05 Changement des données
    [006_newbalance_bitume.csv]
2023-05-15 ajout des images au diapo
2023-05-22 Quelques corrections
    [motif.csv]
2023-06-04 Modif des grahiques
    [motif.csv]
2023-06-05 modif de l'image du modele viscoelastique
2023-06-05 Ajout des incertitudes
